cmwcmw57/pi-backup/ksrc/sim/rl/TEACHER_CMDVEL_REPORT.md

# cmdvel teacher 실험 기록 (2026-10-07)

목표는 모래·외력에서 IK의 `(vx, vy, omega)` 추종을 개선하는 밑단 잔차 정책이다.
teacher는 시뮬레이터의 참 차체속도를 포함한 43D 특권정보를 본다. 현재
`--teacher-direct` 모델은 **실기 배포용 student가 아니다**. 최종 판정은 학습에
쓰지 않은 seed에서 IK와 짝지어 병진·요속도 오차 평균/p90, 고착, 슬립·침하를
함께 확인한다. p90은 에피소드별 90분위값의 평균이다.

## 실패 원인 분리

| 실험 | 개입 | 기본 모래 40쌍, RL−IK | 판정 |
| --- | --- | --- | --- |
| `s36` | RMA 8D 잠재 teacher, 이력 5프레임, PPO 200k | 병진 평균 +0.42%vmax, p90 +0.84 | 실패. 특권 가림 시 행동 차이 0.009~0.018 |
| `s37` | 특권 43D 직접 입력, 다른 조건 동일 | 병진 평균 +0.68%vmax, p90 +0.79; 고착 1/40 | 실패. 잠재 병목만의 문제가 아님 |
| `s38` | `s37`에 참속도 P 제어기(K=0.3) 행동 모방 + 정책 방문상태 재수집 2라운드 | 병진 평균 −0.92%vmax, p90 −0.68; 요 평균 −0.69%ommax | 유효한 초기 정책. 1라운드만 쓰면 병진 p90 +4.05 |
| `s39` | `s38`부터 PPO 100k, std 0.13 | 병진 평균 −1.16%vmax, p90 −0.55 | 평균만 추가 개선 |
| `s40` | `s38`부터 PPO 100k, std 0.041 | 병진 평균 −0.80%vmax, p90 −0.45 | 좁은 탐색이 결정론 평가를 개선하지 않음 |
| `s41` | `s38`부터 PPO 100k, std 0.041, `w_tail=0.03` | 병진 평균 −0.88%vmax, p90 −1.12; 요 p90 −0.75 | 40쌍에서는 개선, 새 80쌍 검증에서 p90 이득 소멸 |
| `s42` | `s41`부터 외력 1 N으로 PPO 100k | 병진 평균 −0.69%vmax, p90 −0.38 | 외력 사후오차와 p90 모두 `s41`보다 악화 |
| `s43` | `s41`부터 에피소드 8→20초, PPO 200k | 병진 평균 −0.93%vmax, p90 −1.05 | 기본 8초는 개선. 어려운 20초의 p90 악화는 유지 |

`s41`의 **새 seed 80쌍**에서는 병진 평균 −0.69%vmax, 병진 p90
**+0.26%vmax**, 요 평균 −0.53%ommax, 요 p90 +0.24%ommax, 슬립 p90 +0.05,
침하 평균 +0.18%zmax였다. 평균만 좋아진 정책을 성공으로 고르지 않는다.

참속도 P(K=0.3) 제어기 40쌍은 병진 평균 −1.26%vmax, p90 −1.41,
요 평균 −0.72%ommax였다. 보상도 스텝당 +0.05 높으므로 개선 행동과
학습 신호는 존재한다. 그러나 슬립 p90 +0.02, 침하 +0.10%zmax의 비용이 있다.

## 외력·긴 주행

`s38`은 1 N 외력 30쌍에서 외력 종료 뒤 1초의 병진오차를 −1.62%vmax,
요오차를 −0.85%ommax 줄였지만 슬립 p90은 +0.05였다. 같은 조건에서 `s41`의
외력 사후 병진오차 이득은 −0.81%vmax(95% CI −1.67~+0.13)로 불확실하고,
`s42`는 −0.45%vmax(−1.34~+0.51)였다. 외력 샘플을 한 번 추가한 것만으로
복구 능력이 개선되지는 않았다.

어려운 모래(`difficulty=1`, `soil_amp=0.35`)의 **20초** 주행 20쌍에서 `s38`은
IK 대비 병진 p90 +1.81%vmax, `s41`은 +1.59%vmax였다. 두 정책 모두
슬립 p90 +0.04, 침하 평균 약 +0.4%zmax였다. 고착은 없었지만 긴 주행의
큰 오차는 해결하지 못했다.
`s43`도 같은 20쌍에서 병진 평균 −0.50%vmax, p90 **+1.61%vmax**,
요 평균 −0.57%ommax, 요 p90 +0.44%ommax였다. 에피소드 길이만 늘리는
방법은 큰 오차를 해결하지 못했다. 참속도 P(K=0.3)도 같은 20쌍에서
병진 평균 −1.14%vmax지만 p90 −0.09%vmax(95% CI −1.22~+1.01)로
큰 오차 개선은 확인되지 않았다. 이는 **단순 비례 제어의 한계**이지 모든
시간가변 잔차 정책의 상한이라는 뜻은 아니다.

## 바퀴별 제어 파일럿 (2026-10-07)

현재 실험된 `s36`~`s45` 정책의 행동은 모두 **차체 3D**다. 환경은
`action_mode=body+wheel`의 7D 행동을 지원한다. 뒤 4D는 IK가 낸 바퀴별
목표속도에 `(1 + 0.30*a_i)`를 곱하고 조향각은 IK가 정한다. ROS 브리지는
3D 정책만 받고 SPI 명령도 `(vx,vy,omega)`이므로 이 7D는 아직 실기 경로가
없다.

`probe_wheel_control.py`에서 동일 시드·동일 명령으로 IK, 참속도 차체
P(K=0.3), 바퀴 슬립 휴리스틱, 조합을 비교했다. 일반 모래 12쌍에서
`P+바퀴 슬립 목표`의 병진 평균은 11.069→9.427 %vmax였지만, 바퀴 네 개를
**공통 증속**한 것만으로도 9.472가 나왔다. 바퀴 간 차등만 남기면 11.147로
오히려 악화됐다. 공통 증속을 바퀴별 트랙션 제어의 성과로 세면 안 된다.
어려운 모래 20초 8쌍에서 강한 차등 규칙은 차체 P 대비 병진 평균
+0.062%vmax, 요 평균 +0.218%ommax로 악화됐다. 차체 P 정책의 상태로
미리 정의한 고슬립 비대칭 구간에서도 병진 −0.095%vmax,
요 +0.342%ommax였다. 이는 한 규칙의 결과일 뿐 7D 정책의 상한은 아니다.

`train_wheel_residual.py`는 **차체 참속도 P를 양쪽에 똑같이 고정**하고,
특권 관측 teacher가 합이 0인 바퀴 4D 차등 잔차만 학습한다. `s46` 파일럿은
단일 환경 50,176스텝, 명령 필터 0.10초, 일반 모래에서 학습했다.

| 미사용 시드 | P 대비 학습 바퀴 잔차 병진 평균 | 병진 p90 | 요 평균 | 고슬립 비대칭 구간 병진 평균 |
| --- | ---: | ---: | ---: | ---: |
| 일반 모래 20쌍, 8초 | +0.081%vmax | −0.400%vmax | +0.096%ommax | −0.183%vmax |
| 어려운 모래 10쌍, 20초 | +0.298%vmax | +0.078%vmax | +0.125%ommax | −0.059%vmax |

고슬립 구간의 이득은 작고, 어려운 모래의 **안정된 명령+고슬립** 구간에서는
병진이 오히려 +0.936%vmax였다. 일반 모래 20쌍 중 가장 나쁜 에피소드의
병진 p90 손해는 +5.579%vmax였다. 사용자 목표는 모든 구간의 우세가 아니라
보정 가능한 구간의 확실한 이득과 나머지 구간의 작은 손해다. 이 파일럿은
아직 그 조건을 만족하지 않는다. 다만 5만 스텝의 단일 학습과 작은 평가
표본이므로, 바퀴별 행동 자체가 불필요하다는 판정은 아니다. 다음에는
고슬립·비대칭 상태의 학습 노출을 늘리고 미리 정의한 구간별 이득 및 손해
상한으로 선택해야 한다.

위 평가 시드로만 **선택형 게이트**를 정했다: 명령 변경 후 0.75초 미만이면서
직전 바퀴 슬립 표준편차가 0.15를 넘을 때만 `s46`의 바퀴 잔차를 사용한다.
그 뒤에는 별도 새 시드에서 평가했다. 게이트에 쓰는 슬립은 시뮬 참값이다.

| 선택형 정책, P 대비 | 병진 평균 | 병진 p90 | 요 평균 | 전환+고슬립 병진 평균 |
| --- | ---: | ---: | ---: | ---: |
| 일반 모래 새 20쌍 | −0.038%vmax [−0.403,+0.262] | −0.880 [−2.925,+0.400] | −0.018%ommax [−0.151,+0.101] | −1.081%vmax, 에피소드 CI [−1.821,+0.272] |
| 어려운 모래 새 10쌍, 20초 | −0.024%vmax [−0.203,+0.120] | −0.473 [−1.477,+0.629] | −0.006%ommax [−0.221,+0.207] | −0.430%vmax, 에피소드 CI [−0.977,+0.175] |

대괄호는 에피소드 짝 bootstrap 95% CI다. 모든 추종 이득 CI가 0을
포함한다. 따라서 선택형 제어는 **유망한 방향**이지만 확실한 개선으로
판정할 수 없다. 일반 모래 최악 에피소드 병진 p90 손해는 +3.560%vmax,
어려운 모래는 +3.122%vmax였다. 게이트가 꺼져 있어도 앞선 행동으로
상태가 달라져 이후 손해가 0이 되지는 않는다. 어려운 모래의 평균 침하는
+0.071%zmax [ +0.005, +0.145 ] 증가했다. 추가 고착/전복은 없었다.

### 5만 스텝이 짧았는가: 같은 학습을 20만 스텝까지 연장

`s47`은 `s46`의 PPO 가중치·옵티마이저·VecNormalize를 이어 받아
총 200,192스텝까지 학습했다. 5만/10만/15만/20만 체크포인트를 **같은**
미사용 시드(기본 모래 12쌍 `30000`, 어려운 모래 20초 6쌍 `31000`)에서
차체 참속도 P와 짝비교했다. 수치는 바퀴 잔차를 더한 효과(바퀴−차체 P)다.

| 총 스텝 | 기본 병진 평균 | 기본 요 p90 | 기본 침하 | 어려운 병진 평균 | 어려운 침하 |
| ---: | ---: | ---: | ---: | ---: | ---: |
| 50k | −0.042%vmax | −0.354%ommax | +0.118%zmax | +0.506%vmax | +0.181%zmax |
| 100k | −0.037 | −0.085 | +0.405 | +0.263 | +0.892 |
| 150k | +0.275 | +1.566 | +0.308 | +0.327 | +0.743 |
| 200k | +0.017 | −0.914 | +0.273 | +0.247 | +0.428 |

같은 시드에서 차체 P 자체는 순수 IK 대비 기본 모래의 평균 병진
−1.343%vmax, 평균 요 −0.736%ommax, 어려운 모래의 평균 병진
−1.769%vmax, 평균 요 −0.939%ommax였다. 이 12/6쌍에서는
**차체 피드백의 이득이 바퀴 차등 정책의 추가 이득보다 크고 일관적**이다.
바퀴 정책의 학습을 4배 늘려도 추종 개선은 안정화되지 않았고, 모든
체크포인트에서 침하는 증가했다. 그러므로 이 특정한 `합 0인 바퀴속도 잔차 +
균일 cmdvel PPO`의 실패를 단순히 5만 스텝 부족으로 설명할 수 없다.
그러나 표본이 작고 바퀴 공통 증감속·다른 행동 표현·고슬립 집중 학습을
시험하지 않았으므로 **바퀴별 제어 일반의 가설을 기각한 것은 아니다**.

### 공통 성분·선택형 학습 재검증

`s48`은 바퀴 잔차의 합을 0으로 제한하지 않고 50,176스텝 학습했다.
새 기본 모래 12쌍에서 차체 P 대비 병진 평균 −0.009%vmax
[−0.250,+0.235], p90 −0.122 [−1.143,+1.135]로 개선을 확인하지 못했고,
침하는 +0.087%zmax [+0.028,+0.152] 증가했다. 따라서 바퀴 네 개의 공통
증감속까지 허용하는 것만으로는 부족하다.

`s49`는 명령 전환 후 0.75초 이내이고 **원시 슬립 표준편차**가 0.15를
넘을 때만 정책이 켜지도록, 어려운 모래 20초 환경에서 총 100,192스텝까지
학습했다. 확인용 별도 시드에서 차체 P 대비 결과는 다음과 같다.

| 확인 표본 | 병진 평균 | 병진 p90 | 요 평균 | 최악 에피소드 병진 p90 손해 |
| --- | ---: | ---: | ---: | ---: |
| 기본 40쌍 | +0.025%vmax [−0.070,+0.113] | +0.255 [−0.052,+0.632] | +0.017%ommax [−0.026,+0.062] | +5.370%vmax |
| 어려운 20쌍 | +0.040%vmax [−0.075,+0.167] | +0.902 [−0.147,+2.141] | +0.106%ommax [+0.003,+0.225] | +8.651%vmax |

두 표본 모두 동일 시드의 명령 일치 최대오차가 0이었다. 이 확인 표본에서
차체 P 자체는 IK 대비 기본 모래 병진 평균 −1.412%vmax
[−1.722,−1.096], 요 평균 −0.715%ommax [−0.829,−0.601]이었다.
어려운 모래에서는 병진 평균 −0.990%vmax [−1.352,−0.594], 요 평균
−0.680%ommax [−0.810,−0.533]이었다. 즉 현재 실험의 차체 참속도 피드백은
재현되지만 바퀴별 정책의 *추가* 개선은 재현되지 않는다. 이는 **oracle
차체 P**의 결과이지 배포 가능한 학습 정책의 성능이 아니다.

이 선택형 학습의 게이트는 이후 계측에서 잘못된 선택 기준임이 드러났다.
`audit_wheel_opportunities.py`로 어려운 모래 20쌍, 약 19,423제어주기를
계측하면 명령 전환 중 원시 슬립 표준편차 >0.15는 **35.2%**지만, 실제
명령 구동 방향에 슬립 부호를 맞추고 접지 중인 바퀴만 본 표준편차 >0.15는
**2.4%**다. 전체에서는 각각 19.6%, 2.6%였다. 회전·방향 전환 시 부호가
다른 바퀴를 `s49`가 잘못 선택했다. 원시 게이트로 학습한 실패를
바퀴별 트랙션 제어 가설의 반증으로 해석할 수 없다.

`soil_amp=1.0`인 진단용 강한 패치에서는 구동 방향 기준 슬립차 >0.05가
전체 20.2%, >0.15가 4.6%였다. 후자 상태의 병진오차는 17.00%vmax로,
나머지 접지 상태의 7.51%vmax보다 크다. 다만 이 연관성만으로 바퀴별
제어가 오차를 줄일 수 있다고 증명되지는 않는다. 구동 방향 기준 게이트로
학습·평가하는 후속 실험이 필요하다.

### 구동 방향 기준 게이트와 어려운 패치 학습 (`s50`)

원시 슬립 부호 착오를 고친 `gate_metric=traction`을 넣었다. 명령 구동
방향에 슬립 부호를 맞추고, 충분한 명령과 접지력이 있는 바퀴가 셋 이상일 때
표준편차가 0.05를 넘으면 차등 바퀴 정책을 켠다. 명령 전환뿐 아니라
2초 명령 구간 전체를 사용한다. 강한 패치(`soil_amp=1.0`)에서
100,352스텝을 처음부터 학습하고 50k/100k 체크포인트를 같은 독립 시드
20쌍씩 평가했다. 모두 **차체 참속도 P를 고정한 상태에서 바퀴 잔차를 추가**한
결과다.

| 학습 스텝 | 검증 분포 | P 대비 병진 평균 | 병진 p90 | 요 평균 | 침하 평균 |
| ---: | --- | ---: | ---: | ---: | ---: |
| 50k | 강한 패치 20쌍 | +0.326%vmax [−0.262,+1.254] | +0.579 [−1.474,+3.513] | −0.079%ommax [−0.393,+0.130] | +0.252%zmax |
| 100k | 강한 패치 20쌍 | +0.210%vmax [+0.029,+0.454] | +0.005 [−0.717,+0.663] | +0.087%ommax [+0.020,+0.154] | +0.207%zmax [+0.090,+0.352] |
| 50k | 목표 모래 20쌍 | +0.193%vmax [−0.053,+0.539] | +0.352 [−0.267,+1.167] | +0.055%ommax [−0.031,+0.165] | −0.023%zmax |
| 100k | 목표 모래 20쌍 | +0.117%vmax [−0.145,+0.410] | +0.670 [−0.243,+1.725] | +0.014%ommax [−0.095,+0.127] | +0.033%zmax |

50k를 강한 패치의 다른 6쌍에서만 보면 병진 p90 −0.876%vmax였으나
CI [−2.071,+0.101]로 불확실했고, 20쌍으로 늘리자 이득이 사라졌다.
50k→100k에서 병진 **평균 손해는 줄었으므로** 학습량 부족을 완전히
배제할 수는 없다. 다만 의도한 강한 비대칭 슬립(구동 방향 기준 표준편차
>0.15)에서 병진오차의 스텝 평균은 50k +0.785, 100k +0.906%vmax로
모두 나빠졌다. 이 구간은 원래 차체 P 궤적의 상태로 미리 선택했다.
에피소드 길이가 다른 구간의 스텝 가중 평균과 에피소드별 bootstrap CI는
가중법이 달라, 여기서는 구간 CI로 유의성 판정을 하지 않는다.

같은 강한 패치 20쌍에서 차체 P는 IK보다 병진 평균 −1.689%vmax
[−2.392,−1.136], 요 평균 −0.561%ommax [−0.822,−0.321]이었다.
목표 모래 20쌍에서는 병진 평균 −1.478%vmax [−1.762,−1.164], 요 평균
−0.601%ommax [−0.811,−0.390]이었다. 따라서 **현재는 차체 참속도
피드백의 평균 오차 이득만 재현됐다**. 이것은 참값 oracle이며 학습된
차체 teacher 또는 실기 배포 정책의 이득이라는 뜻은 아니다.

`s50`은 실험적 강한 패치, 최대 ±30% 바퀴속도 잔차, 차등 성분,
PPO 100k의 결과다. 바퀴별 액션 일반의 가설을 기각하지 않는다. 다만
현재 구성에서 학습 시간을 무작정 늘리기보다, 바퀴 행동으로 실제
오차를 줄일 수 있는 상태를 별도로 입증하고 그 상태를 반복 학습시키는
것이 우선이다.

추가로 구동 방향 기준 슬립 차이를 줄이는 단순 차등 규칙을 강한 패치
8쌍에서 시험했다(`probe_wheel_control.py`, `wheel_mode=differential`,
`wheel_gain=2`). 차체 P 대비 병진 평균 +1.539%vmax, p90 +2.851,
고비대칭 슬립 구간 병진 스텝 평균 +0.399%vmax로 악화됐다. 이 규칙의
실패는 최적 바퀴 정책이 없다는 증거는 아니다. 특히 현재 terramech의
접지 마찰계수는 슬립 절댓값에 대해 포화하며 **단조 증가**하고, 침하
저항은 별도로 누적된다. 과도한 회전을 줄이면 즉시 접지력이 오르는
타이어 모델을 가정한 규칙을 그대로 적용할 수 없다.

강한 패치 10쌍의 상태 계측에서는 **의미 있는 구동 명령과 접지를 동시에
가진 바퀴가 3개 미만**인 주기가 전체 31.5%였고 그때 병진오차는
29.38%vmax였다. 셋 이상인 68.5% 주기의 병진오차는 8.15%vmax였다.
이는 접지 바퀴 수 자체만을 센 값이 아니라, 구동 명령이 거의 0인 바퀴도
제외한 값이다. 큰 오차의 상당수가 명령 전환·조향 대기 등 바퀴속도
차등 보정이 힘을 내기 어려운 상태에 몰릴 가능성을 보여준다. 접촉 원인과
조향 대기를 따로 계측하기 전에는 이를 모두 공중 바퀴 탓으로 돌릴 수 없다.

명령 변경 뒤 구간별 진단(20쌍): `s41`은 0.75~2초에는 병진 평균 −1.11,
p90 −0.87%vmax였지만 첫 0~0.25초의 병진 p90은 +1.59%vmax였다.
0.25~0.75초의 IK 병진 p90 자체가 41.92%vmax다. 조향 최고속도
5.2 rad/s에서는 180° 회전에 약 0.60초가 필요하므로 전환 구간 오차는
제어 한계와 분리해 해석해야 한다. 단순히 명령 변경 후 0.25/0.5초 동안
잔차를 차단하면 기본 40쌍의 병진 p90은 `s41`의 22.10에서 각각 22.73,
23.11%vmax로 악화되어 채택하지 않았다.

ROS 브리지는 기본 `cmd_filter_tau=0.10s`이고, 이전 cmdvel 학습은
`alpha=1/(0.3*50)=0.06667`이었다. 브리지의 계수식은
`alpha=dt/(tau+dt)`이다. 환경에 `cmd_filter_tau`를 노출하고 동일한
식으로 고쳤다. 기본 0.28s는 종전 alpha를 정확히 보존하며 0.10s는
ROS와 같은 alpha=0.16667이다.

ROS 기본 0.10s 필터의 새 seed 30쌍(`seed0=16000`)에서 `s43`은 IK 대비
병진 평균 −0.49%vmax, p90 **+1.04%vmax**, 요 p90 +1.00%ommax였다.
반면 참속도 P(K=0.3)는 병진 평균 −1.35%vmax, p90 **−1.82%vmax**
(95% CI −3.44~−0.23)였다. 따라서 빠른 명령에서도 보정 여지는 있는데
기존 teacher가 그 분포를 재현하지 못한다.

0.10s 명령으로 두 라운드 행동 모방한 `s44`도 같은 30쌍에서 병진 p90
+1.31%vmax였다. 별도 40쌍(`seed0=18000`)에서는 병진 평균 −0.75%vmax,
p90 −0.19%vmax(95% CI −1.66~+1.71)로 큰 오차 이득은 불확실하다.
행동과 속도오차의 상관은 0.94~0.96이고 축별 유효 P 이득도 0.28~0.34로
목표 0.3에 가깝지만, 작은 모방 오차가 폐루프 p90에 영향을 준다.

## 같은 상태 바퀴별 권한 실험 (2026-10-07)

`probe_wheel_same_state.py`로 **같은 MuJoCo 물리 상태·흙 침하 메모리·IK
fold 상태·명령/지연·난수 상태**를 복제했다. 참속도 차체 P(K=0.3)는 모든
분기에서 동일하게 유지하고, 그 위의 바퀴별 잔차만 0.30초 동안 바꿨다.
선택 기준은 P 기준 궤적에서 구동·접지 바퀴 3개 이상, 조향 정렬 대기 아님,
명령 시작 후 0.75~1.50초, 구동 방향 기준 슬립 표준편차가 목표 모래 0.05
또는 강한 패치 0.12 이상이다. 에피소드당 최대 2상태만 택했다. 차등 후보는
한 바퀴/바퀴쌍의 ±입력과 슬립·흙 마찰계수 기준 입력으로 구성했고, 모든
바퀴의 평균 보정은 0이다. 별도로 네 바퀴 공통 증감도 시험했다. 바퀴당
허용 범위는 기존의 IK 속도 ±30%다.

| 패치 | 상태 수 (시드 수) | P 병진/요 오차 | 사후 최선 차등 Δ병진/Δ요 | 단순 슬립 감소 Δ병진/Δ요 | `s50` Δ병진/Δ요 |
| --- | ---: | ---: | ---: | ---: | ---: |
| 목표 `soil_amp=0.25` | 33 (18) | 7.02 / 4.37 | −1.22 / −1.20 | +1.62 / +1.48 | +0.09 / +0.09 |
| 강한 `soil_amp=1.0` | 23 (15) | 12.18 / 8.06 | −1.34 / −0.40 | +0.66 / +1.89 | −0.01 / −0.11 |

수치는 각 상태에서 0.30초 평균 오차의 차이이며 각각 `%v_max`,
`%omega_max` 단위다. 음수가 개선이다. `s50`은 매 20ms마다 실제 학습
정책을 다시 호출하고 학습 당시 게이트(슬립 편차 >0.05, 명령 시작 뒤
2초 이내)를 적용했다. 목표 모래의 `s50` 병진 차이의 시드 단위 bootstrap
95% CI는 [−0.05,+0.22]%v_max, 강한 패치는 [−0.45,+0.21]%v_max다.
차등 후보 중 병진과 요오차를 **함께** 줄이는 입력이 목표 모래 26/33,
강한 패치 19/23 상태에 있었다. 그러나 `s50`은 각각 10/33, 8/23뿐이다.

따라서 **현재 물리 모델과 액션 범위 안에 국소 바퀴별 보정 권한은 있지만,
`s50`은 이를 배우지 못했다.** 사후 최선은 미래 0.30초를 보고 유한한
후보들 중 고른 값이라 정책의 성능이 아니고, 한 상태의 단기 개선이 긴
에피소드의 p90·침하 개선을 보장하지도 않는다. 또한 참속도 P 위에 얹은
결과이므로 실기 배포 가능한 student의 성능이라는 주장도 아니다.
반대로 이 결과만으로 바퀴별 제어 가설을 기각할 수는 없다. 슬립 큰 바퀴를
그냥 늦추는 규칙은 두 분포 모두에서 실패했고, 최선 후보의 방향도 상태마다
달랐다. 강한 패치에서 공통 바퀴 증감의 사후 최선 병진 개선은 −2.49%v_max로
차등보다 컸지만, 이것은 바퀴별 재분배의 성과가 아니다.

논문 ERNEST는 속도 명령을 저수준 제어에 넣고 상대적인 바퀴 하중을
관측한다. 이 환경은 IK 바퀴속도를 **개루프 duty**로 바꾼다. 그래서
알고리즘·보상 숫자를 옮기기 전에, 같은 상태에서 후보가 달라지는 원인을
관측으로 예측 가능한지 검사하고, 바퀴 속도 폐루프/행동 유지시간을 별도
가설로 시험해야 한다. `s50`을 같은 분포에서 단순 연장 학습하는 것만으로
개선된다고 볼 근거는 없다.

재현 예시 (현재 `sim/rl`에서 실행):

```bash
OPENBLAS_NUM_THREADS=1 python3 probe_wheel_same_state.py --episodes 20 --seed0 42000 --episode-s 10 --soil-amp 0.25 --spread 0.05 --policy-model ../../runs/s50_wheel_traction_gate_100k/model.zip --policy-vecnorm ../../runs/s50_wheel_traction_gate_100k/vecnorm.pkl --out /tmp/ksrc_wheel_probe_target_s50.json
OPENBLAS_NUM_THREADS=1 python3 probe_wheel_same_state.py --episodes 20 --seed0 41000 --episode-s 10 --soil-amp 1.0 --spread 0.12 --policy-model ../../runs/s50_wheel_traction_gate_100k/model.zip --policy-vecnorm ../../runs/s50_wheel_traction_gate_100k/vecnorm.pkl --out /tmp/ksrc_wheel_probe_strong_s50.json
```

## 정상 주행의 지속 오차를 겨냥한 teacher 개선 (`s51`, 2026-10-07)

ROS와 같은 `cmd_filter_tau=0.10s`에서 `s45`를 새 기본 모래 40쌍으로
평가했다. IK 대비 병진 평균 −0.73%vmax [−1.16,−0.25], 요 평균
−0.51%ommax [−0.71,−0.26]였지만, 병진 p90 이득은 불확실했다.
명령 시작 0.75~2초의 병진 p90은 IK 12.14, `s45` 13.52,
참속도 P(K=0.3) 10.08%vmax였다(20쌍). `s45`가 모방해야 할
지속 오차 보정이 남아 있었다.

그래서 `behavior_clone_cmdvel.py`에 **명령 시작 후 0.75초가 지난
병진오차 샘플의 모방 손실 가중치**를 추가했다. `s45`에서 시작해
80개 에피소드의 참속도 P 시범·정책 방문상태를 두 라운드로 모으고,
`steady-tail-weight=3`으로 학습한 결과가 `s51`이다. 이는 PPO 보상
최적화가 아니라 **특권 teacher의 지도학습/DAgger 추가 학습**이다.

| 독립 평가 | 지표 | IK | `s45` | `s51` | `s51−s45` 짝 bootstrap 95% CI |
| --- | --- | ---: | ---: | ---: | ---: |
| 기본 모래 40쌍, 8초 | 병진 평균, %vmax | 11.915 | 10.634 | **10.421** | **−0.213 [−0.339,−0.087]** |
| | 병진 p90, %vmax | 26.610 | 26.153 | **25.277** | **−0.876 [−1.603,−0.241]** |
| | 요 평균, %ommax | 4.940 | 4.416 | 4.406 | −0.010 [0 포함] |
| | 요 p90, %ommax | 9.851 | 10.498 | **9.685** | **−0.812 [−1.471,−0.277]** |
| 어려운 모래 20쌍, 20초 | 병진 평균, %vmax | 13.862 | 12.893 | **12.501** | **−0.392 [−0.864,−0.085]** |
| | 병진 p90, %vmax | 32.223 | 32.007 | 31.355 | −0.651 [0 포함] |
| | 평균 침하, %zmax | 3.900 | 4.151 | 4.051 | −0.100 [−0.215,−0.020] |

기본 모래는 미사용 seed `36000`부터 40쌍, `difficulty=0.8`,
`soil_amp` 기본값이다. 어려운 모래는 seed `38000`부터 20쌍,
`difficulty=1`, `soil_amp=0.35`다. 모든 팔의 명령 차이 최대값은 0,
고착·전복·경계 이탈은 0이었다. 기본 모래의 `s51−IK` 병진 평균은
−1.493%vmax [−1.821,−1.152]이지만 병진 p90은 −1.333
[−2.471,+0.100]으로 **IK 대비 p90 개선은 아직 확정되지 않았다**.
슬립 p90은 IK 0.500, `s51` 0.522이고 침하는 IK 2.544,
`s51` 2.690%zmax로 증가했다. 어려운 모래에서도 `s51` 침하가 IK보다
+0.151%zmax [+0.011,+0.290] 높았다.

1 N 외력 20쌍(seed `39000`)에서는 `s51−IK` 외력 후 병진 평균
−1.032%vmax [−1.986,−0.118]였다. 그러나 `s51−s45`는 +0.041
[−0.351,+0.405]로 **이전 teacher 대비 외력 복구 향상은 입증되지 않았다**.
`s51`은 일반 명령 추종을 개선한 teacher이며 실기용 student가 아니다.
참속도 특권 관측과 정상화 파일이 필요하고, ROS의 배포 모델로 바로
바꾸면 안 된다.

별도 가설로 참속도 P 위에 10Hz TD3 잔차(`s52`, 10k스텝)를 학습했다.
미사용 seed `47000`부터 20쌍에서 P 대비 병진 평균 +1.493%vmax
[+0.702,+2.350], 요 p90 +2.435%ommax [+0.186,+4.759],
침하 +0.430%zmax [+0.279,+0.605]로 악화됐다. 5k 체크포인트도
병진 평균·요 평균·침하가 악화됐다. 따라서 TD3 잔차는 **채택하지 않는다**.

### 더 강한 모래 패치 외삽 평가

`difficulty=1.0`은 지형 생성기의 상한이지만 기본 에피소드 난도는
`U(0.6,1.0)`으로 뽑힌다. 따라서 아래 두 평가는 최상위 난도만 고정한
것이 아니라 상위 난도가 섞인 분포다. `soil_amp=1.0`은 기본
0.25보다 바퀴별 모래 마찰 차이를 네 배 키운 스트레스 시험이다.
`soil_field`에서 배율의 표준편차가 난이도에 비례해 증가하고, 최종 바퀴
마찰계수는 `[0.15,1.20]`으로 잘린다. 이 정도 패치가 실제 경기장 모래의
측정 분포라는 근거는 없으므로 **분포 밖 내구성 시험**으로 해석한다.

미사용 seed `50000`부터 20쌍, 20초, 0.10초 명령 필터에서 결과는 다음과 같다.

| 지표 | IK | `s45` | `s51` | 참속도 P |
| --- | ---: | ---: | ---: | ---: |
| 병진 평균, %vmax | 19.501 | 18.280 | 18.493 | 19.938 |
| 병진 p90, %vmax | 43.324 | 41.663 | 42.482 | 46.445 |
| 요 평균, %ommax | 8.551 | 7.798 | 7.879 | 8.307 |
| 평균 침하, %zmax | 4.706 | 5.092 | 5.228 | 5.342 |
| 고착 에피소드 | 2/20 | 3/20 | 3/20 | 3/20 |

`s51−IK` 병진 평균은 −1.008%vmax [−2.142,+0.056]으로 CI가 0을
포함한다. 침하는 **+0.522%zmax [+0.138,+0.911]**로 확실히 높다.
`s51−s45` 병진 평균은 +0.213%vmax [−0.380,+1.030]이며 s51의
일반 모래 개선은 여기서 유지되지 않는다. 참속도 P도 IK보다 병진 평균·p90이
나빠졌으므로 이 조건에서 P 행동을 더 모방하는 방향은 부적절하다.
모든 팔의 명령 불일치는 0이었다.

중간 패치 `soil_amp=0.5`에서도 같은 `difficulty=1.0`, 20초,
새 seed `51000`부터 20쌍을 평가했다. IK/`s45`/`s51`/참속도 P의 병진
평균은 13.697/12.524/12.485/12.445%vmax였다. `s51−IK`는
−1.212 [−1.612,−0.804]로 평균 추종 개선이 남았으나, 병진 p90
−0.687 [−2.184,+0.721]은 불확실하다. `s51−s45` 병진 평균
−0.039 [−0.244,+0.208]로 추가 이득은 사라졌고, 요 평균은
+0.147%ommax [+0.005,+0.336] 악화됐다. IK 대비 슬립 p90은
+0.056 [+0.024,+0.096], 침하는 +0.431%zmax [+0.154,+0.775]였다.
고착·전복·경계 이탈은 네 팔 모두 0이었다.

같은 `soil_amp=0.5` 20쌍에서 `s51`의 출력만 50%로 줄이는 절제 실험을
했다. 병진 평균은 12.485→12.964%vmax로 **+0.479
[+0.195,+0.703] 악화**했지만, 슬립 p90은 0.590→0.570
[차이 −0.040,−0.001], 침하는 4.761→4.584%zmax
[차이 −0.300,−0.080]로 감소했다. 즉 잔차를 줄이면 피해가 완화되지만
보정 이득도 일부 잃는다. 단순히 행동 전체에 0.5를 곱한 모델을 최종
정책으로 채택할 근거는 없다.

`soil_amp=1.0`에서도 앞선 평가와 겹치는 12쌍의 탐색 결과, 50% 출력은
원래 `s51`보다 병진 평균 **+1.376%vmax [+0.409,+2.571]**, 요 평균
+0.885%ommax [+0.275,+1.713]로 악화됐다. 침하는 −0.395%zmax
[−0.772,−0.141] 감소했다. 같은 시드를 재사용한 **절제 진단**이며,
절반 출력이 추종을 개선한다는 증거는 아니다. 이 규모 축소는 채택하지 않는다.

PPO 외의 연속행동 알고리즘으로 `s53` SAC를 시험했다. 참속도 P를
고정한 위에 10Hz 차체 잔차를 얹고, `difficulty=1.0`, `soil_amp=1.0`,
12초 에피소드에서 10k macro-step을 학습했다. `s51`의 관측 정규화
통계를 고정해 썼고, 잔차 크기는 기존 행동 한계의 25%였다. 새 seed
`55000`부터 20쌍에서 P 대비 병진 평균 **+1.058%vmax
[+0.171,+2.001]**로 악화했고, 고착은 P 0/20, SAC 1/20이었다.
학습 보상이 증가해도 독립 평가가 나빠진 경우다. 같은 20쌍에서 5k
체크포인트의 P 대비 병진 평균은 +1.793%vmax
[−0.308,+5.278], 요 평균은 +0.427%ommax [+0.044,+0.837]였다.
따라서 **SAC도 채택하지 않는다**. 이는 SAC 알고리즘 일반의
실패가 아니라 이 보상·관측·10k스텝·참속도 P 기준선의 결과다.

### 난도를 매번 최댓값으로 고정한 지형

기존 `difficulty=1.0`의 에피소드별 난도는 `U(0.6,1.0)`이었다. 환경에
`difficulty_min_frac`를 추가하되 기본값은 0.6으로 유지했다. 평가에
`--difficulty-min-frac 1`을 주면 매 에피소드의 지형·흙 난도가 정확히
`d_ep=1.0`이 된다. `soil_amp=0.5`를 유지하고 독립 seed `60000`부터
20쌍, 20초를 평가했다.

| 지표 | IK | `s45` | `s51` | 참속도 P | `s51−IK` 짝 bootstrap 95% CI |
| --- | ---: | ---: | ---: | ---: | ---: |
| 병진 평균, %vmax | 14.769 | 13.943 | 14.350 | 13.730 | −0.419 [−1.237,+0.874] |
| 병진 p90, %vmax | 31.593 | 31.676 | 33.085 | 31.712 | +1.492 [−1.688,+5.794] |
| 요 평균, %ommax | 7.189 | 6.717 | 6.906 | 6.666 | −0.283 [−0.620,+0.192] |
| 슬립 p90 | 0.542 | 0.589 | 0.594 | 0.596 | +0.052 [+0.017,+0.087] |
| 평균 침하, %zmax | 6.144 | 6.654 | 7.006 | 6.880 | **+0.862 [+0.333,+1.612]** |

고착·전복·경계 이탈은 모두 0/20, 명령 불일치 최대값은 0이다.
`s51−s45` 병진 평균은 +0.407%vmax [−0.266,+1.437]로 추가 이득이
확인되지 않았고, p90은 +1.409 [−1.106,+4.898]이다. 최악 난도에서
평균·꼬리 오차의 이득은 불확실하지만 침하와 슬립 비용은 확인됐다.
따라서 **현재 s51의 유효 범위는 이전의 일반 모래 검증 조건까지**이며,
최상위 난도에 그대로 적용할 근거는 없다. P oracle도 침하를 키우므로
P 모방만 더 하는 것이 해결책은 아니다. 이 결과는 20쌍의 시뮬 모델
스트레스 시험이지 실제 경기장 모래의 성능 보증이 아니다.

### 어려운 지형에서 PPO 이어학습 (`s54`, 2026-10-07)

`s51`의 223D 특권 관측·3D 차체 잔차 PPO를 이어서 학습했다. 난도는 매
에피소드 `U(0.9,1.0)`, `soil_amp=0.5`, 20초, ROS와 같은 0.10초 명령
필터다. `w_tail=0.03`, 8환경, 추가 100k스텝, 이어학습률 `3e-5`,
목표 KL `0.01`, 탐색 표준편차 `exp(-3.2)`를 사용했다. 모방학습으로 바뀐
actor 때문에 PPO optimizer는 초기화했으며 정규화 통계는 이어받아
학습 분포에서 업데이트했다. 이전 환경 스냅샷과 현재의 난도 하한 옵션이
달라 `--allow-source-change`를 명시했다. 유효 런은
`runs/s54_cmdvel_hardtail_ppo_100k_retry/`에 있고, 같은 이름에서
`_retry`가 없는 디렉터리는 샌드박스의 병렬 프로세스 생성 차단으로
학습 전에 종료된 시도다.

체크포인트 선택용 미사용 seed `65000`부터 12쌍, 난도 1.0 고정·패치
0.5·20초에서 50k 모델은 `s51` 대비 병진 평균 +0.104%vmax
[−0.156,+0.360], 요 평균 +0.188%ommax [+0.011,+0.421],
침하 +0.157%zmax [+0.021,+0.322]였다. 100k 모델은 병진 평균
−0.370 [−1.020,+0.136]으로 개선 여부가 불확실하고, IK 대비 요 p90은
+1.871%ommax [+0.037,+3.866]로 악화했다. 이 12쌍은 모델 선택에
사용했으므로 채택 근거로 삼지 않는다.

별도의 일반 모래(`difficulty=0.8`, `soil_amp=0.25`, 8초) seed `68000`
30쌍에서 `s54−s51` 병진 평균은 **−0.254%vmax
[−0.432,−0.064]**, 병진 p90은 +0.077 [−0.906,+1.432],
평균 침하는 −0.020%zmax [−0.048,+0.006]이었다. 일반 모래에서는
평균 추종이 추가 개선됐으나 p90·침하 개선은 확인되지 않았다.
학습 목표인 최상위 난도의 별도 30쌍 결과는 아래와 같다.

최상위 난도 고정(`difficulty=1`, `difficulty_min_frac=1`, `soil_amp=0.5`,
20초)의 **새 seed `66000`부터 30쌍** 결과는 다음과 같다. 같은 시드의
명령 차이 최대값은 0이다.

| 지표 | IK | `s51` | `s54` 100k | `s54−s51` 짝 bootstrap 95% CI | `s54−IK` 짝 bootstrap 95% CI |
| --- | ---: | ---: | ---: | ---: | ---: |
| 병진 평균, %vmax | 14.341 | 12.817 | 12.809 | −0.008 [−0.253,+0.335] | −1.532 [−2.156,−0.985] |
| 병진 p90, %vmax | 33.977 | 31.363 | 31.618 | +0.255 [−0.705,+1.080] | −2.358 [−4.258,−0.694] |
| 요 평균, %ommax | 6.628 | 5.989 | 6.302 | **+0.313 [+0.144,+0.543]** | −0.326 [−0.629,−0.021] |
| 슬립 p90 | 0.616 | 0.641 | 0.672 | **+0.032 [+0.012,+0.055]** | +0.056 [+0.025,+0.093] |
| 평균 침하, %zmax | 4.445 | 4.576 | 4.864 | **+0.288 [+0.039,+0.632]** | +0.419 [+0.144,+0.764] |
| 고착 에피소드 | 0/30 | 0/30 | 1/30 | 1건 추가 | 1건 추가 |

`s54`는 IK보다 병진 추종을 개선하지만, **기존 s51 대비 추가 병진 이득은
확인되지 않았다**. 요 평균·슬립·침하는 악화됐고 고착도 하나 발생했다.
일반 모래의 평균 병진 −0.254%vmax 추가 이득은 이 비용을 상쇄한다고
보기 어렵다. 따라서 `s54`는 실험 모델로 보존하되 기본 teacher로
**채택하지 않는다**. 이 실험에서 학습을 더 늘리는 것만으로 해결된다는
증거도 없다. P oracle/현 보상이 침하·고착 비용을 충분히 나타내는지와
보정이 유리한 상태를 따로 구분할 수 있는지를 다음 가설로 확인해야 한다.

재현 예시 (`sim/rl`에서 실행):

```bash
OPENBLAS_NUM_THREADS=1 python3 compare_cmdvel_models.py --old-model runs/s45_cmdvel_teacher_bc_ros_tau_refine/model.zip --old-vecnorm runs/s45_cmdvel_teacher_bc_ros_tau_refine/vecnorm.pkl --new-model runs/s51_cmdvel_steady_tail_bc/model.zip --new-vecnorm runs/s51_cmdvel_steady_tail_bc/vecnorm.pkl --episodes 40 --seed0 36000 --cmd-filter-tau 0.10
OPENBLAS_NUM_THREADS=1 python3 compare_cmdvel_models.py --old-model runs/s45_cmdvel_teacher_bc_ros_tau_refine/model.zip --old-vecnorm runs/s45_cmdvel_teacher_bc_ros_tau_refine/vecnorm.pkl --new-model runs/s51_cmdvel_steady_tail_bc/model.zip --new-vecnorm runs/s51_cmdvel_steady_tail_bc/vecnorm.pkl --episodes 20 --seed0 38000 --episode-s 20 --difficulty 1 --soil-amp 0.35 --cmd-filter-tau 0.10
OPENBLAS_NUM_THREADS=1 python3 compare_cmdvel_models.py --old-model runs/s45_cmdvel_teacher_bc_ros_tau_refine/model.zip --old-vecnorm runs/s45_cmdvel_teacher_bc_ros_tau_refine/vecnorm.pkl --new-model runs/s51_cmdvel_steady_tail_bc/model.zip --new-vecnorm runs/s51_cmdvel_steady_tail_bc/vecnorm.pkl --episodes 20 --seed0 60000 --episode-s 20 --difficulty 1 --difficulty-min-frac 1 --soil-amp 0.5 --cmd-filter-tau 0.10
OPENBLAS_NUM_THREADS=1 python3 compare_cmdvel_models.py --old-model runs/s51_cmdvel_steady_tail_bc/model.zip --old-vecnorm runs/s51_cmdvel_steady_tail_bc/vecnorm.pkl --new-model runs/s54_cmdvel_hardtail_ppo_100k_retry/final.zip --new-vecnorm runs/s54_cmdvel_hardtail_ppo_100k_retry/vecnorm.pkl --episodes 30 --seed0 66000 --episode-s 20 --difficulty 1 --difficulty-min-frac 1 --soil-amp 0.5 --cmd-filter-tau 0.10
```

## 재현과 다음 판정

각 `runs/sNN.../manifest.json`에 인자·소스 해시, `src/`에 실행 당시 코드가
남아 있다. `compare_policy.py`는 동일 seed로 IK와 정책을 짝비교하지만
주행 궤적이 갈라진 뒤 센서 잡음 난수 소비까지 완전히 공통은 아니다.
`probe_cmdvel_phase.py`는 명령 변경 후 구간별 오차를 출력한다.

현재 선택할 수 있는 **검증 완료 배포 모델은 없다**. `s51`은 `s45`보다
독립 시드의 일반 모래 명령 추종이 개선된 teacher다. 최상위 난도에서는
시드에 따라 IK 대비 추종 이득이 달라지고 침하 비용이 남아 있다. 어려운
지형 PPO 이어학습 `s54`는 `s51`보다 요 평균·슬립·침하를 악화시켜
채택하지 않았다. 실기 센서만으로 가능한
속도 추정/관측과 student 증류, 그 student의 독립 재평가가 다음 판정이다.

## 보상 항 진단과 논문 코드 검토 (2026-10-07)

최상위 난도 고정·새 seed `66000`부터 30쌍을 `w_tail=0.03`으로
재계산했다. 아래는 에피소드별 스텝 평균을 다시 30개 에피소드에 대해
평균한 값이다. 짝 bootstrap 95% CI를 썼다.

| 스텝당 보상 항 | `s51` | `s54` | `s54−s51` 95% CI |
| --- | ---: | ---: | ---: |
| 병진 추종 `track_v` | +0.404832 | +0.402794 | −0.002039 [−0.010272,+0.003814] |
| 요 추종 `track_om` | +0.318348 | +0.313345 | **−0.005003 [−0.007875,−0.002663]** |
| 큰 오차 비용 `tail` | −0.066912 | −0.066518 | +0.000394 [−0.005824,+0.007697] |
| 잔차 사용 `resid` | −0.000191 | −0.000212 | −0.000021 [−0.000029,−0.000013] |
| 잔차 2차 차분 `smooth` | −0.000023 | −0.000025 | −0.000002 [−0.000003,−0.000001] |
| 합계 | +0.656055 | +0.649201 | −0.006854 [−0.021956,+0.003130] |

따라서 단순히 `smooth` 비용이 커서 정책이 조용히 있는 경우로 볼 수 없다.
`s54`의 추종 보상 자체가 늘지 않았고, 요 추종 보상은 줄었다. 현재
cmdvel 보상에는 스텝별 슬립·침하·명령 포화 비용이 없다. 고착 종료
벌점은 있으나 고착 이전의 침하 누적은 직접 반영하지 않는다. 저항이
큰 모래에서는 명령을 더 세게 줄수록 슬립·침하가 커져도 추종 오차가
별로 줄지 않는 상태가 있는지 상태별로 확인해야 한다. 보상 탓으로
단정하기 전에 IK와 teacher의 동일 초기 상태·명령에서 **안전한 개선
행동이 실제로 존재하는지**와 그 행동이 보상에서 더 높은지 분리해야 한다.

사용자가 제공한 두 PDF와 추가로 논의한 ERNEST 논문의 공개 코드를
2026-10-07에 확인했다.

| 논문 | 공개 코드 | 현재 cmdvel teacher에 적용 가능성 |
| --- | --- | --- |
| [Joglekar et al. 2022, skid-steer adaptive Pure Pursuit](https://www.sciencedirect.com/science/article/pii/S2405896322028592) | 저자 [Deep_Reinforcement_Adaptive_Pure_Pursuit](https://github.com/ajinkya-joglekar/Deep_Reinforcement_Adaptive_Pure_Pursuit), ROS1 catkin·MATLAB/Gazebo 코드. PDF 참고문헌의 `mecc_22_rl_pid` 경로는 현재 열리지 않고 저자 계정의 이 저장소가 공개돼 있다. | RL 행동은 전진속도·lookahead이며 하위 구동기 슬립 보정 코드가 아니다. Nav2 경로 추종기 조정 실험에만 간접 참고. `RL_pipeline.m`에는 관측의 속도 자리에 명령 속도를 넣고, 보상의 목표 속도 1.5가 actor 출력 범위 0.2–0.5 밖에 있는 불일치도 있어 그대로 이식하지 않는다. |
| [Lee & Joe 2026, 4WIS path tracking](https://doi.org/10.3390/s26061761) | PDF에 공개 코드 링크가 없고 데이터는 저자 요청 시 제공이라고 기재. 제목·저자·DOI로 검색해 공식 GitHub 저장소를 확인하지 못했다. | 25D 경로 관측, PPO 59M 스텝, 가상 구동각속도·조향각 행동을 하위 wheel-wise 기구학에 배분하는 **상위 경로 추종기**다. 현재 차체 `(vx,vy,omega)` 밑단 잔차 학습에는 보상을 직접 복사하면 목표가 달라진다. 실측 조향 지연·GPS 잡음을 랜덤화 범위로 잡는 방법은 실기 이전 단계에 참고 가능. |
| [Bouton et al. 2026, ERNEST](https://arxiv.org/html/2606.06790v2) | 저자가 링크한 [MachineLearning/TD3.py](https://github.com/arthur-bouton/MachineLearning/blob/master/TD3.py)는 TensorFlow 2.3.1 기반 범용 TD3와 pendulum/cartpole 예제다. DARTS 로버 환경·학습 설정·체크포인트는 해당 저장소에 없다. | TD3의 경험 재사용, 지형별 학습 후 replay 통합, 이전 행동 관측, 토양 모델의 drawbar-pull 실측 검증은 적용 아이디어다. 다만 행동은 전진속도와 능동 서스펜션 yaw/roll 속도이고 보상은 경로 진행·횡오차·서스펜션 토크라 현재 스워브 차체 속도 잔차에 직접 이식할 수 없다. |

특히 2026 4WIS와 ERNEST는 경로를 **앞으로** 추종하는 실험이다. 현재
cmdvel 과제는 임의의 차체 `(vx, vy, omega)`를 추종하므로, 경로 진행·전방
헤딩 게이트를 그대로 넣으면 횡이동·후진 명령을 잘못 벌할 수 있다. 이
보상들은 Nav2 상위 경로 추종 과제에서 별도로 비교할 항목이다.

다음 비교는 **같은 물리·명령·시드의 heldout**에서 보상만 바꾼 teacher를
IK/`s51`과 짝지어 본다. 먼저 문제 구간을 슬립·침하·조향 대기·속도오차로
분리하고, 회복 가능한 구간의 속도·요 오차 이득과 회복 불가 구간의
고착/침하 악화를 함께 측정한다. ERNEST식 지형별 replay 통합은
모래 단일 목표에서 지형별 성공 정책을 확보한 뒤 검토한다.
