cmwcmw57/pi-backup/ksrc/sysid_logs/20261013_093046_drive_m234/report.txt

== 구동 분석: sysid_logs/20261013_093046_drive_m234
   시험 156개, 반복 5, 움직인 모터 [2, 3, 4], 2026-10-13 09:30:46 ~ 2026-10-13 09:38:58

[측정 조건]
  [PASS] 샘플 타이밍: late_max 1 us (허용 100)
  REF(duty 400) 평균속도 순서대로: 3.827 3.869 3.874 3.876 3.873 3.868 3.871 3.879 3.888 3.878 3.879 3.892 3.893 3.881 3.878 3.890 rad/s
  그때 서보 전압: 11.7 11.7 11.7 11.7 11.6 11.6 11.6 11.6 11.6 11.6 11.6 11.6 11.6 11.6 11.6 11.6 V
  [PASS] 배터리·온도 표류 (REF): 처음 대비 +1.65%, 범위 1.74% (허용 2%)

[D1] duty → 정상속도 (각 반복 따로 직선 피팅: ω = k·(duty − 데드밴드))
  duty       M2 (평균±표준편차)       M3 (평균±표준편차)       M4 (평균±표준편차)
  -799    -7.238 ± 0.266        -7.824 ± 0.043        -7.425 ± 0.007    
    ! 튀는 반복: duty -799 M2 반복 2: -7.623 (나머지 중앙값 -7.080)
  -400    -3.942 ± 0.043        -3.982 ± 0.006        -3.858 ± 0.007    
  -200    -1.964 ± 0.009        -1.971 ± 0.003        -1.890 ± 0.003    
  -160    -1.557 ± 0.012        -1.569 ± 0.010        -1.494 ± 0.011    
  -120    -1.154 ± 0.010        -1.168 ± 0.004        -1.089 ± 0.020    
   -80    -0.744 ± 0.002        -0.755 ± 0.008        -0.675 ± 0.023    
   -40    -0.335 ± 0.004        -0.291 ± 0.007        -0.178 ± 0.011    
   +40    +0.265 ± 0.005        +0.318 ± 0.009        +0.076 ± 0.105    
    ! 튀는 반복: duty 40 M4 반복 1: +0.191 (나머지 중앙값 +0.000)
    ! 튀는 반복: duty 40 M4 반복 2: +0.191 (나머지 중앙값 +0.000)
   +80    +0.727 ± 0.015        +0.752 ± 0.009        +0.659 ± 0.004    
  +120    +1.154 ± 0.005        +1.163 ± 0.009        +1.050 ± 0.007    
  +160    +1.558 ± 0.004        +1.572 ± 0.008        +1.432 ± 0.006    
  +200    +1.963 ± 0.011        +1.964 ± 0.008        +1.815 ± 0.009    
  +300    +2.968 ± 0.007        +2.965 ± 0.010        +2.765 ± 0.018    
  +400    +3.961 ± 0.016        +3.956 ± 0.006        +3.703 ± 0.020    
  +500    +4.942 ± 0.019        +4.940 ± 0.008        +4.640 ± 0.036    
  +600    +5.875 ± 0.036        +5.909 ± 0.010        +5.554 ± 0.050    
  +700    +6.838 ± 0.054        +6.888 ± 0.010        +6.495 ± 0.051    
  +799    +7.598 ± 0.055        +7.806 ± 0.013        +7.415 ± 0.032    
  모터  ω0 전진 (duty 799) rad/s     ω0 후진               데드밴드 전진 duty   데드밴드 후진    비선형(최대)
  M2   7.753 ± 0.020 (n=5)   7.354 ± 0.270 (n=5)   2.8 ± 1.2 (n=5)   8.9 ± 7.0 (n=5)   2.6% / 4.3%
  M3   7.862 ± 0.008 (n=5)   7.849 ± 0.045 (n=5)   2.2 ± 0.5 (n=5)   1.3 ± 0.7 (n=5)   0.9% / 1.0%
  M4   7.429 ± 0.014 (n=5)   7.481 ± 0.008 (n=5)   7.3 ± 1.1 (n=5)   1.3 ± 1.4 (n=5)   1.1% / 1.7%
  ω0 평균 7.681 rad/s = 바퀴 0.365 m/s (반경 0.047503).  모터 개체차 M2 +0.9%, M3 +2.3%, M4 -3.3%
  [PASS] M2 ω0 fwd 반복성: 95%CI ±0.020 (허용 ±0.078)
  [PASS] M2 데드밴드 fwd 반복성: 95%CI ±1.2 duty (허용 ±5)
  [FAIL] M2 ω0 rev 반복성: 95%CI ±0.270 (허용 ±0.074)
  [FAIL] M2 데드밴드 rev 반복성: 95%CI ±7.0 duty (허용 ±5)
  [PASS] M3 ω0 fwd 반복성: 95%CI ±0.008 (허용 ±0.079)
  [PASS] M3 데드밴드 fwd 반복성: 95%CI ±0.5 duty (허용 ±5)
  [PASS] M3 ω0 rev 반복성: 95%CI ±0.045 (허용 ±0.078)
  [PASS] M3 데드밴드 rev 반복성: 95%CI ±0.7 duty (허용 ±5)
  [PASS] M4 ω0 fwd 반복성: 95%CI ±0.014 (허용 ±0.074)
  [PASS] M4 데드밴드 fwd 반복성: 95%CI ±1.1 duty (허용 ±5)
  [PASS] M4 ω0 rev 반복성: 95%CI ±0.008 (허용 ±0.075)
  [PASS] M4 데드밴드 rev 반복성: 95%CI ±1.4 duty (허용 ±5)
  #9 정상상태 속도 잡음 (20 ms 창): 중앙값 0.0188 rad/s  (1틱 양자화만이면 ~0.0153, 최대 0.0375)

[D2] 계단 응답 (위치 궤적에 1차 + 지연 피팅, 반복·모터별)
  0 200 100 700     
     M2  τ 42.0 ± 4.3 ms (n=5)   지연 0.2 ± 0.6 ms (n=5)   끝속도 +1.950   피팅잔차 0.034 rad/s
     M3  τ 36.4 ± 4.3 ms (n=5)   지연 1.4 ± 1.7 ms (n=5)   끝속도 +1.980   피팅잔차 0.036 rad/s
     M4  τ 33.6 ± 3.5 ms (n=5)   지연 2.5 ± 2.2 ms (n=5)   끝속도 +1.856   피팅잔차 0.039 rad/s
  0 400 100 700     
     M2  τ 40.7 ± 0.0 ms (n=5)   지연 0.2 ± 0.3 ms (n=5)   끝속도 +3.971   피팅잔차 0.040 rad/s
     M3  τ 39.3 ± 1.2 ms (n=5)   지연 0.5 ± 0.4 ms (n=5)   끝속도 +3.963   피팅잔차 0.040 rad/s
     M4  τ 37.1 ± 0.9 ms (n=5)   지연 0.5 ± 0.4 ms (n=5)   끝속도 +3.732   피팅잔차 0.042 rad/s
  0 799 100 700     
     M2  τ 41.1 ± 3.0 ms (n=5)   지연 0.4 ± 0.5 ms (n=5)   끝속도 +7.609   피팅잔차 0.084 rad/s
     M3  τ 41.6 ± 1.0 ms (n=5)   지연 0.3 ± 0.6 ms (n=5)   끝속도 +7.617   피팅잔차 0.081 rad/s
     M4  τ 36.7 ± 3.8 ms (n=5)   지연 1.0 ± 1.5 ms (n=5)   끝속도 +7.310   피팅잔차 0.068 rad/s
  799 0 100 1200    
     M2  τ 33.8 ± 1.6 ms (n=5)   지연 7.6 ± 1.4 ms (n=5)   끝속도 +0.000   피팅잔차 0.091 rad/s
     M3  τ 31.7 ± 1.7 ms (n=5)   지연 7.5 ± 1.3 ms (n=5)   끝속도 +0.000   피팅잔차 0.089 rad/s
     M4  τ 30.1 ± 1.2 ms (n=5)   지연 7.0 ± 0.8 ms (n=5)   끝속도 +0.000   피팅잔차 0.082 rad/s
  400 -400 100 1200 
     M2  τ 38.7 ± 1.6 ms (n=5)   지연 0.5 ± 0.8 ms (n=5)   끝속도 -3.973   피팅잔차 0.050 rad/s
     M3  τ 39.3 ± 1.2 ms (n=5)   지연 0.6 ± 0.5 ms (n=5)   끝속도 -3.965   피팅잔차 0.062 rad/s
     M4  τ 43.1 ± 1.0 ms (n=5)   지연 0.0 ± 0.0 ms (n=5)   끝속도 -3.841   피팅잔차 0.119 rad/s
  0 -799 100 700    
     M2  τ 41.9 ± 1.6 ms (n=5)   지연 0.4 ± 0.3 ms (n=5)   끝속도 -7.642   피팅잔차 0.105 rad/s
     M3  τ 41.0 ± 0.8 ms (n=5)   지연 0.4 ± 0.5 ms (n=5)   끝속도 -7.618   피팅잔차 0.071 rad/s
     M4  τ 44.1 ± 2.6 ms (n=5)   지연 0.1 ± 0.3 ms (n=5)   끝속도 -7.397   피팅잔차 0.124 rad/s
  [PASS] M2 τ (0 400 100 700) 반복성: 40.7 ms, 95%CI ±0.0 (허용 ±4.1)
  [PASS] M2 지연 반복성: 0.2 ms, 95%CI ±0.3 (허용 ±2)
  [PASS] M3 τ (0 400 100 700) 반복성: 39.3 ms, 95%CI ±1.2 (허용 ±3.9)
  [PASS] M3 지연 반복성: 0.5 ms, 95%CI ±0.4 (허용 ±2)
  [PASS] M4 τ (0 400 100 700) 반복성: 37.1 ms, 95%CI ±0.9 (허용 ±3.7)
  [PASS] M4 지연 반복성: 0.5 ms, 95%CI ±0.4 (허용 ±2)
  τ 비교 (모터 평균, 0→400 대비):
     0 200 100 700      τ   37.4 ms  ×0.96
     0 400 100 700      τ   39.0 ms  ×1.00
     0 799 100 700      τ   39.8 ms  ×1.02
     799 0 100 1200     τ   31.9 ms  ×0.82  ← 제동 (MDD3A 브레이크)
     400 -400 100 1200  τ   40.4 ms  ×1.03  ← 역전
     0 -799 100 700     τ   42.3 ms  ×1.08
  → 반사관성 J = τ·D: D(토크-속도 기울기)를 D5 에서 재면 J = 0.0390·D  (D=0.246 이면 9.60e-03 kg·m², 지금 시뮬 armature 1.5e-3)
  D1 정상속도 vs D2 끝속도 (같은 duty, 다른 시험):
  [FAIL] 정상속도 일치 duty +200: 최대 차이 2.3% (허용 2%)
  [PASS] 정상속도 일치 duty +400: 최대 차이 0.8% (허용 2%)
  [FAIL] 정상속도 일치 duty +799: 최대 차이 2.4% (허용 2%)
  [FAIL] 정상속도 일치 duty -799: 최대 차이 5.6% (허용 2%)

[D3] 저속 램프: 기동 duty(정지→회전) / 정지 duty(회전→정지)
  기동 = 확실히 돈 뒤(50 ms 창 속도 > 문턱이 50 ms) 거슬러 올라가 엔코더가 처음 움직인 샘플의 duty − 램프기울기×지연
  정지 = 엔코더가 50 ms 동안 안 움직이기 시작한 샘플의 duty + 램프기울기×(지연+τ).  기동을 D1 데드밴드(운동마찰)와 비교한다.
  -150 0 2000 2000 RAMP  정지 duty: M2 32.3 ± 1.4 (n=5)   M3 32.4 ± 3.1 (n=5)   M4 35.8 ± 1.2 (n=5)
  0 -150 2000 2000 RAMP  기동 duty: M2 41.2 ± 2.8 (n=5)   M3 36.6 ± 2.4 (n=5)   M4 44.2 ± 1.6 (n=5)
  [PASS] M2 기동 duty (-150) 반복성: 95%CI ±2.8 (허용 ±6)
  [PASS] M3 기동 duty (-150) 반복성: 95%CI ±2.4 (허용 ±6)
  [PASS] M4 기동 duty (-150) 반복성: 95%CI ±1.6 (허용 ±6)
  0 150 2000 2000 RAMP   기동 duty: M2 38.4 ± 2.6 (n=5)   M3 40.8 ± 1.0 (n=5)   M4 41.4 ± 8.4 (n=5)
  [PASS] M2 기동 duty (150) 반복성: 95%CI ±2.6 (허용 ±6)
  [PASS] M3 기동 duty (150) 반복성: 95%CI ±1.0 (허용 ±6)
  [FAIL] M4 기동 duty (150) 반복성: 95%CI ±8.4 (허용 ±6)
  150 0 2000 2000 RAMP   정지 duty: M2 32.7 ± 0.7 (n=5)   M3 30.2 ± 2.4 (n=5)   M4 34.4 ± 3.1 (n=5)
  M2 전진: 기동(정지마찰) 38.4 − D1 데드밴드(운동마찰) 2.8 = +35.6 duty → 정지마찰 있음 (시뮬 FF·마찰에 반영 검토)
  M2 후진: 기동(정지마찰) 41.2 − D1 데드밴드(운동마찰) 8.9 = +32.3 duty → 정지마찰 있음 (시뮬 FF·마찰에 반영 검토)
  M3 전진: 기동(정지마찰) 40.8 − D1 데드밴드(운동마찰) 2.2 = +38.6 duty → 정지마찰 있음 (시뮬 FF·마찰에 반영 검토)
  M3 후진: 기동(정지마찰) 36.6 − D1 데드밴드(운동마찰) 1.3 = +35.3 duty → 정지마찰 있음 (시뮬 FF·마찰에 반영 검토)
  M4 전진: 기동(정지마찰) 41.4 − D1 데드밴드(운동마찰) 7.3 = +34.1 duty → 정지마찰 있음 (시뮬 FF·마찰에 반영 검토)
  M4 후진: 기동(정지마찰) 44.2 − D1 데드밴드(운동마찰) 1.3 = +42.9 duty → 정지마찰 있음 (시뮬 FF·마찰에 반영 검토)

[검증] D1 표 + '0 400 100 700' 의 τ·지연만으로 만든 1차 모델이 피팅에 안 쓴 시험을 맞히는가
  오차 = 모델 vs 반복 평균 궤적 RMS (10 ms 창 속도).  잡음 바닥 = 반복끼리의 RMS 편차.
  PASS 조건: 오차 ≤ max(2 × 잡음 바닥, 최고속도의 3%)
  [FAIL] 모델 검증 D2 0 -799 100 700: 오차/허용 rad/s: M2 0.329/0.231✗  M3 0.213/0.230  M4 0.145/0.223
  [PASS] 모델 검증 D2 0 200 100 700: 오차/허용 rad/s: M2 0.021/0.080  M3 0.026/0.072  M4 0.045/0.087
  [PASS] 모델 검증 D2 0 799 100 700: 오차/허용 rad/s: M2 0.062/0.230  M3 0.205/0.256  M4 0.102/0.221
  [PASS] 모델 검증 D2 400 -400 100 1200: 오차/허용 rad/s: M2 0.071/0.120  M3 0.056/0.120  M4 0.091/0.117
  [PASS] 모델 검증 D2 799 0 100 1200: 오차/허용 rad/s: M2 0.111/0.233  M3 0.113/0.226  M4 0.082/0.218
  [FAIL] 모델 검증 D3 -150 0 2000 2000 RAMP: 오차/허용 rad/s: M2 0.077/0.062✗  M3 0.074/0.061✗  M4 0.061/0.064
  [FAIL] 모델 검증 D3 0 -150 2000 2000 RAMP: 오차/허용 rad/s: M2 0.099/0.073✗  M3 0.075/0.066✗  M4 0.063/0.073
  [FAIL] 모델 검증 D3 0 150 2000 2000 RAMP: 오차/허용 rad/s: M2 0.073/0.066✗  M3 0.095/0.059✗  M4 0.042/0.106
  [FAIL] 모델 검증 D3 150 0 2000 2000 RAMP: 오차/허용 rad/s: M2 0.067/0.060✗  M3 0.076/0.060✗  M4 0.061/0.064

== 종합: 확인 39개 중 FAIL 11개
   FAIL M2 ω0 rev 반복성: 95%CI ±0.270 (허용 ±0.074)
   FAIL M2 데드밴드 rev 반복성: 95%CI ±7.0 duty (허용 ±5)
   FAIL 정상속도 일치 duty +200: 최대 차이 2.3% (허용 2%)
   FAIL 정상속도 일치 duty +799: 최대 차이 2.4% (허용 2%)
   FAIL 정상속도 일치 duty -799: 최대 차이 5.6% (허용 2%)
   FAIL M4 기동 duty (150) 반복성: 95%CI ±8.4 (허용 ±6)
   FAIL 모델 검증 D2 0 -799 100 700: 오차/허용 rad/s: M2 0.329/0.231✗  M3 0.213/0.230  M4 0.145/0.223
   FAIL 모델 검증 D3 -150 0 2000 2000 RAMP: 오차/허용 rad/s: M2 0.077/0.062✗  M3 0.074/0.061✗  M4 0.061/0.064
   FAIL 모델 검증 D3 0 -150 2000 2000 RAMP: 오차/허용 rad/s: M2 0.099/0.073✗  M3 0.075/0.066✗  M4 0.063/0.073
   FAIL 모델 검증 D3 0 150 2000 2000 RAMP: 오차/허용 rad/s: M2 0.073/0.066✗  M3 0.095/0.059✗  M4 0.042/0.106
   FAIL 모델 검증 D3 150 0 2000 2000 RAMP: 오차/허용 rad/s: M2 0.067/0.060✗  M3 0.076/0.060✗  M4 0.061/0.064
