cmwcmw57/pi-backup/ksrc/sysid_logs/20261013_095438_steer_servo1/report.txt

== 조향 분석: sysid_logs/20261013_095438_steer_servo1   (STEP 78개)

[ACC 0]  계단크기   10→90% ms            최고속(위치미분) 도/s    도달 ms               오버슈트 도
          80°   475 ± 1 (n=12)      194 ± 3 (n=12)          823 ± 1 (n=12)      0.00 ± 0.00 (n=12)
          45°   356 ± 3 (n=6)       145 ± 6 (n=6)           606 ± 4 (n=6)       0.00 ± 0.00 (n=6)
          15°   207 ± 1 (n=6)       81 ± 5 (n=6)            338 ± 2 (n=6)       0.00 ± 0.00 (n=6)
           5°   128 ± 8 (n=6)       44 ± 3 (n=6)            185 ± 4 (n=6)       0.00 ± 0.00 (n=6)
           3°   96 ± 11 (n=4)       36 ± 4 (n=6)            132 ± 4 (n=6)       0.00 ± 0.00 (n=6)  ! 90% 못 감 2회
  사다리꼴 피팅: 가속 439 도/s² = 7.7 rad/s², 최고속 170 도/s = 2.97 rad/s, 잔차 5.1 ms
  [PASS] ACC 0 80° 10→90% 반복성: 475 ms, 95%CI ±1 (허용 ±48)
  [PASS] ACC 0 사다리꼴 모델 적합: 계단 크기 5개에 잔차 5.1 ms
  궤적 피팅 가속도 443 도/s² = 7.7 rad/s², 최고속 170 도/s 고정
  시작 지연 L (궤적 피팅, 명령 송신 → 움직임 시작): 33.9 ± 1.2 ms (n=36)   (펌웨어 '시작 지연' 줄은 0.5도 도달 시각이라 가속 제한이 섞임)
  [PASS] ACC 0 궤적 모델 적합 (RAW): RMS/허용 도: 80° 0.14/2.40  45° 0.10/1.35  15° 0.06/0.50  5° 0.06/0.50  3° 0.05/0.50
  [PASS] ACC 0 시작 지연 반복성: 95%CI ±1.2 ms (허용 ±2)

[ACC 50]  계단크기   10→90% ms            최고속(위치미분) 도/s    도달 ms               오버슈트 도
          80°   475 ± 2 (n=12)      193 ± 3 (n=12)          823 ± 2 (n=12)      0.00 ± 0.00 (n=12)
          45°   356 ± 3 (n=6)       146 ± 6 (n=6)           606 ± 3 (n=6)       0.00 ± 0.00 (n=6)
          15°   208 ± 1 (n=6)       79 ± 4 (n=6)            339 ± 2 (n=6)       0.00 ± 0.00 (n=6)
           5°   127 ± 7 (n=6)       44 ± 3 (n=6)            185 ± 3 (n=6)       0.00 ± 0.00 (n=6)
           3°   99 ± 9 (n=6)        34 ± 0 (n=6)            132 ± 5 (n=6)       0.00 ± 0.00 (n=6)
  사다리꼴 피팅: 가속 439 도/s² = 7.7 rad/s², 최고속 170 도/s = 2.97 rad/s, 잔차 5.6 ms   (Feetech 단위 100 step/s² 가정 시 ACC 50 = 439 도/s²)
  [PASS] ACC 50 80° 10→90% 반복성: 475 ms, 95%CI ±2 (허용 ±48)
  [PASS] ACC 50 사다리꼴 모델 적합: 계단 크기 5개에 잔차 5.6 ms
  궤적 피팅 가속도 443 도/s² = 7.7 rad/s², 최고속 170 도/s 고정
  시작 지연 L (궤적 피팅, 명령 송신 → 움직임 시작): 33.7 ± 1.1 ms (n=36)   (펌웨어 '시작 지연' 줄은 0.5도 도달 시각이라 가속 제한이 섞임)
  [PASS] ACC 50 궤적 모델 적합 (RAW): RMS/허용 도: 80° 0.14/2.40  45° 0.10/1.35  15° 0.07/0.50  5° 0.06/0.50  3° 0.04/0.50
  [PASS] ACC 50 시작 지연 반복성: 95%CI ±1.1 ms (허용 ±2)
  궤적 72개 → steer_traj.npz (시뮬에 같은 계단 넣어 비교용: t s, 각도 도, 속도, 부하)

[ACC 50 vs 0]  (시뮬: 최고속 5.45 rad/s = 312 도/s, 가속 제한 없음)
  80° 10→90%: ACC50 475 ms, ACC0 475 ms, 차이 +0 ± 2 ms → 차이 구별 안 됨
  80° 도달: ACC50 823 ms, ACC0 823 ms, 차이 +0 ± 2 ms → 차이 구별 안 됨

== 종합: 확인 8개 중 FAIL 0개
   전부 PASS: 반복성·측정조건·모델 검증 통과.  summary.json 값을 시뮬에 반영해도 된다.
