cmwcmw57/pi-backup/ksrc/sysid_logs/20261013_100010_steer_servo1/report.txt

== 조향 분석: sysid_logs/20261013_100010_steer_servo1   (STEP 52개)

[ACC 100]  계단크기   10→90% ms            최고속(위치미분) 도/s    도달 ms               오버슈트 도
          90°   503 ± 2 (n=8)       206 ± 0 (n=8)           874 ± 2 (n=8)       0.00 ± 0.00 (n=8)
          45°   356 ± 5 (n=4)       141 ± 8 (n=4)           606 ± 5 (n=4)       0.00 ± 0.00 (n=4)
          15°   208 ± 2 (n=4)       80 ± 6 (n=4)            339 ± 2 (n=4)       0.00 ± 0.00 (n=4)
           5°   126 ± 13 (n=4)      45 ± 6 (n=4)            186 ± 5 (n=4)       0.00 ± 0.00 (n=4)
           3°   99 ± 14 (n=4)       34 ± 1 (n=4)            133 ± 6 (n=4)       0.00 ± 0.00 (n=4)
  사다리꼴 피팅: 가속 439 도/s² = 7.7 rad/s², 최고속 190 도/s = 3.32 rad/s, 잔차 5.5 ms   (Feetech 단위 100 step/s² 가정 시 ACC 100 = 879 도/s²)
  [PASS] ACC 100 90° 10→90% 반복성: 503 ms, 95%CI ±2 (허용 ±50)
  [PASS] ACC 100 사다리꼴 모델 적합: 계단 크기 5개에 잔차 5.5 ms
  궤적 피팅 가속도 443 도/s² = 7.7 rad/s², 최고속 190 도/s 고정
  시작 지연 L (궤적 피팅, 명령 송신 → 움직임 시작): 34.5 ± 1.4 ms (n=24)   (펌웨어 '시작 지연' 줄은 0.5도 도달 시각이라 가속 제한이 섞임)
  [PASS] ACC 100 궤적 모델 적합 (RAW): RMS/허용 도: 90° 0.10/2.70  45° 0.10/1.35  15° 0.06/0.50  5° 0.07/0.50  3° 0.04/0.50
  [PASS] ACC 100 시작 지연 반복성: 95%CI ±1.4 ms (허용 ±2)

[ACC 254]  계단크기   10→90% ms            최고속(위치미분) 도/s    도달 ms               오버슈트 도
          90°   502 ± 2 (n=8)       204 ± 2 (n=8)           874 ± 2 (n=8)       0.00 ± 0.00 (n=8)
          45°   356 ± 5 (n=4)       143 ± 7 (n=4)           606 ± 5 (n=4)       0.00 ± 0.00 (n=4)
          15°   208 ± 2 (n=4)       79 ± 6 (n=4)            339 ± 4 (n=4)       0.00 ± 0.00 (n=4)
           5°   127 ± 12 (n=4)      45 ± 6 (n=4)            185 ± 5 (n=4)       0.00 ± 0.00 (n=4)
           3°   100 ± 13 (n=4)      36 ± 7 (n=4)            132 ± 6 (n=4)       0.00 ± 0.00 (n=4)
  사다리꼴 피팅: 가속 439 도/s² = 7.7 rad/s², 최고속 190 도/s = 3.32 rad/s, 잔차 5.8 ms   (Feetech 단위 100 step/s² 가정 시 ACC 254 = 2232 도/s²)
  [PASS] ACC 254 90° 10→90% 반복성: 502 ms, 95%CI ±2 (허용 ±50)
  [PASS] ACC 254 사다리꼴 모델 적합: 계단 크기 5개에 잔차 5.8 ms
  궤적 피팅 가속도 443 도/s² = 7.7 rad/s², 최고속 190 도/s 고정
  시작 지연 L (궤적 피팅, 명령 송신 → 움직임 시작): 34.4 ± 1.3 ms (n=24)   (펌웨어 '시작 지연' 줄은 0.5도 도달 시각이라 가속 제한이 섞임)
  [PASS] ACC 254 궤적 모델 적합 (RAW): RMS/허용 도: 90° 0.10/2.70  45° 0.10/1.35  15° 0.06/0.50  5° 0.07/0.50  3° 0.04/0.50
  [PASS] ACC 254 시작 지연 반복성: 95%CI ±1.3 ms (허용 ±2)
  궤적 48개 → steer_traj.npz (시뮬에 같은 계단 넣어 비교용: t s, 각도 도, 속도, 부하)

== 종합: 확인 8개 중 FAIL 0개
   전부 PASS: 반복성·측정조건·모델 검증 통과.  summary.json 값을 시뮬에 반영해도 된다.
