cmwcmw57/pi-backup/ksrc/sysid_logs/20261013_100707_steer_servo2/report.txt

== 조향 분석: sysid_logs/20261013_100707_steer_servo2   (STEP 26개)

[ACC 50]  계단크기   10→90% ms            최고속(위치미분) 도/s    도달 ms               오버슈트 도
          90°   502 ± 4 (n=7)       205 ± 1 (n=7)           873 ± 4 (n=6)       0.00 ± 0.00 (n=6)
          45°   355 ± 6 (n=4)       143 ± 6 (n=4)           605 ± 6 (n=4)       0.00 ± 0.00 (n=4)
          15°   206 ± 6 (n=4)       81 ± 8 (n=4)            338 ± 6 (n=4)       0.00 ± 0.00 (n=4)
           5°   126 ± 15 (n=4)      45 ± 6 (n=4)            183 ± 7 (n=4)       0.00 ± 0.00 (n=4)
           3°   95 ± 140 (n=2)      34 ± 0 (n=4)            130 ± 8 (n=4)       0.00 ± 0.00 (n=4)  ! 90% 못 감 2회
  사다리꼴 피팅: 가속 439 도/s² = 7.7 rad/s², 최고속 190 도/s = 3.32 rad/s, 잔차 3.8 ms   (Feetech 단위 100 step/s² 가정 시 ACC 50 = 439 도/s²)
  [PASS] ACC 50 90° 10→90% 반복성: 502 ms, 95%CI ±4 (허용 ±50)
  [PASS] ACC 50 사다리꼴 모델 적합: 계단 크기 5개에 잔차 3.8 ms
  궤적 피팅 가속도 443 도/s² = 7.7 rad/s², 최고속 190 도/s 고정
  시작 지연 L (궤적 피팅, 명령 송신 → 움직임 시작): 34.0 ± 1.4 ms (n=23)   (펌웨어 '시작 지연' 줄은 0.5도 도달 시각이라 가속 제한이 섞임)
  [PASS] ACC 50 궤적 모델 적합 (RAW): RMS/허용 도: 90° 0.09/2.70  45° 0.10/1.35  15° 0.09/0.50  5° 0.07/0.50  3° 0.07/0.50
  [PASS] ACC 50 시작 지연 반복성: 95%CI ±1.4 ms (허용 ±2)
  궤적 23개 → steer_traj.npz (시뮬에 같은 계단 넣어 비교용: t s, 각도 도, 속도, 부하)

== 종합: 확인 4개 중 FAIL 0개
   전부 PASS: 반복성·측정조건·모델 검증 통과.  summary.json 값을 시뮬에 반영해도 된다.
