cmwcmw57/pi-backup/ksrc/sysid_logs/20261013_101113_steer_servo4/report.txt

== 조향 분석: sysid_logs/20261013_101113_steer_servo4   (STEP 26개)

[ACC 50]  계단크기   10→90% ms            최고속(위치미분) 도/s    도달 ms               오버슈트 도
          90°   501 ± 2 (n=8)       204 ± 2 (n=8)           872 ± 2 (n=8)       0.00 ± 0.00 (n=8)
          45°   357 ± 6 (n=4)       143 ± 13 (n=4)          606 ± 6 (n=4)       0.00 ± 0.00 (n=4)
          15°   206 ± 1 (n=4)       79 ± 6 (n=4)            338 ± 5 (n=4)       0.00 ± 0.00 (n=4)
           5°   124 ± 14 (n=4)      47 ± 7 (n=4)            182 ± 8 (n=4)       0.00 ± 0.00 (n=4)
           3°   98 ± 12 (n=4)       38 ± 8 (n=4)            129 ± 6 (n=4)       0.00 ± 0.00 (n=4)
  사다리꼴 피팅: 가속 439 도/s² = 7.7 rad/s², 최고속 190 도/s = 3.32 rad/s, 잔차 4.6 ms   (Feetech 단위 100 step/s² 가정 시 ACC 50 = 439 도/s²)
  [PASS] ACC 50 90° 10→90% 반복성: 501 ms, 95%CI ±2 (허용 ±50)
  [PASS] ACC 50 사다리꼴 모델 적합: 계단 크기 5개에 잔차 4.6 ms
  궤적 피팅 가속도 443 도/s² = 7.7 rad/s², 최고속 190 도/s 고정
  시작 지연 L (궤적 피팅, 명령 송신 → 움직임 시작): 34.1 ± 1.3 ms (n=24)   (펌웨어 '시작 지연' 줄은 0.5도 도달 시각이라 가속 제한이 섞임)
  [PASS] ACC 50 궤적 모델 적합 (RAW): RMS/허용 도: 90° 0.10/2.70  45° 0.11/1.35  15° 0.09/0.50  5° 0.09/0.50  3° 0.07/0.50
  [PASS] ACC 50 시작 지연 반복성: 95%CI ±1.3 ms (허용 ±2)
  궤적 24개 → steer_traj.npz (시뮬에 같은 계단 넣어 비교용: t s, 각도 도, 속도, 부하)

== 종합: 확인 4개 중 FAIL 0개
   전부 PASS: 반복성·측정조건·모델 검증 통과.  summary.json 값을 시뮬에 반영해도 된다.
