cmwcmw57/pi-backup/ksrc/sysid_logs/20261013_101541_steersmall_servo1/report.txt

== 조향 작은 계단 분석: sysid_logs/20261013_101541_steersmall_servo1   (RAW STEP 124개, 1 스텝 = 0.088도)
  서보 레지스터: 가속도 50, 데드존 CW 1 / CCW 1 스텝 (= 0.088 / 0.088도)

[S3] 히스테리시스: 0도에 -5 쪽 / +5 쪽에서 다가가 멈춘 위치 (서보 출력축 엔코더 기준)
  반복 0: 아래에서 -0.205, 위에서 +0.090  → 차이 +0.295도
  반복 1: 아래에서 -0.260, 위에서 +0.090  → 차이 +0.350도
  반복 2: 아래에서 -0.260, 위에서 +0.090  → 차이 +0.350도
  반복 3: 아래에서 -0.260, 위에서 +0.260  → 차이 +0.520도
  반복 4: 아래에서 -0.260, 위에서 +0.090  → 차이 +0.350도
  히스테리시스 0.373 ± 0.106도 (n=5) → 있음: 데드존 ≈ ±0.19도
  [FAIL] 히스테리시스 반복성: 95%CI ±0.106도 (허용 ±0.1)

[S2] 작은 계단: 0 에서 ±A 로 명령 (out 만).  움직임 = 최종이 시작에서 1 스텝 이상
   A 도     움직인 비율     |최종−목표| 중앙값 도 (움직인 것만)
   0.10     0/ 6 (  0%)     nan
   0.20     1/ 8 ( 12%)     0.110
   0.30     4/10 ( 40%)     0.210
   0.50    10/10 (100%)     0.105
   1.00    10/10 (100%)     0.210
   1.50    10/10 (100%)     0.180
  움직이기 시작하는 최소 명령 (반복마다, 그 이상 전부 움직인 가장 작은 A): 0.50 ± 0.00도 (n=5)
  → 시뮬 조향에 명령 데드밴드 ≈ 0.25~0.50도 (A 격자 사이에 있음)
  [PASS] 최소 명령 반복성: 95%CI ±0.00도 (허용 ±0.2)
  주의: 서보 엔코더는 출력축에 있어 서보 바깥(혼·커플링·조향 링크) 놀음은 여기 안 보인다.
        바퀴 쪽 놀음은 손으로 조향축을 좌우로 밀며 P 명령 각도가 안 변하는 범위를 따로 본다.

== 종합: 확인 2개 중 FAIL 1개
   FAIL 히스테리시스 반복성: 95%CI ±0.106도 (허용 ±0.1)
