cmwcmw57/pi-backup/ksrc/sysid_logs/20261013_102224_drive/report.txt

== 구동 분석: sysid_logs/20261013_102224_drive
   시험 156개, 반복 5, 움직인 모터 [1, 2, 3, 4], 2026-10-13 10:22:24 ~ 2026-10-13 10:31:45

[측정 조건]
  [PASS] 샘플 타이밍: late_max 1 us (허용 100)
  REF(duty 400) 평균속도 순서대로: 3.848 3.840 3.841 3.841 3.836 3.836 3.836 3.838 3.837 3.839 3.829 3.828 3.836 3.822 3.822 3.828 rad/s
  그때 서보 전압: 11.3 11.3 11.3 11.3 11.3 11.3 11.3 11.3 11.3 11.2 11.2 11.2 11.2 11.2 11.2 11.2 V
  [PASS] 배터리·온도 표류 (REF): 처음 대비 -0.53%, 범위 0.68% (허용 2%)

[D1] duty → 정상속도 (각 반복 따로 직선 피팅: ω = k·(duty − 데드밴드))
  duty       M1 (평균±표준편차)       M2 (평균±표준편차)       M3 (평균±표준편차)       M4 (평균±표준편차)
  -799    -7.394 ± 0.085        -7.687 ± 0.012        -7.302 ± 0.095        -7.256 ± 0.070    
  -400    -3.862 ± 0.007        -3.883 ± 0.007        -3.894 ± 0.009        -3.747 ± 0.003    
  -200    -1.944 ± 0.007        -1.916 ± 0.006        -1.920 ± 0.005        -1.837 ± 0.007    
  -160    -1.556 ± 0.006        -1.515 ± 0.012        -1.524 ± 0.011        -1.453 ± 0.014    
  -120    -1.165 ± 0.005        -1.123 ± 0.004        -1.131 ± 0.005        -1.062 ± 0.021    
   -80    -0.772 ± 0.005        -0.719 ± 0.004        -0.728 ± 0.006        -0.664 ± 0.015    
   -40    -0.349 ± 0.003        -0.245 ± 0.137        -0.255 ± 0.002        -0.065 ± 0.090    
    ! 튀는 반복: duty -40 M2 반복 1: +0.000 (나머지 중앙값 -0.302)
    ! 튀는 반복: duty -40 M4 반복 0: -0.164 (나머지 중앙값 +0.000)
    ! 튀는 반복: duty -40 M4 반복 4: -0.163 (나머지 중앙값 +0.000)
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
     M2  τ 39.8 ± 1.0 ms (n=5)   지연 1.0 ± 0.0 ms (n=5)   끝속도 -3.856   피팅잔차 0.058 rad/s
     M3  τ 40.4 ± 0.8 ms (n=5)   지연 0.3 ± 0.3 ms (n=5)   끝속도 -3.882   피팅잔차 0.057 rad/s
     M4  τ 41.3 ± 1.0 ms (n=5)   지연 0.5 ± 0.6 ms (n=5)   끝속도 -3.753   피팅잔차 0.096 rad/s
  0 -799 100 700    
     M1  τ 37.4 ± 2.5 ms (n=5)   지연 0.8 ± 0.7 ms (n=5)   끝속도 -7.279   피팅잔차 0.070 rad/s
     M2  τ 44.4 ± 1.1 ms (n=5)   지연 0.4 ± 0.5 ms (n=5)   끝속도 -7.636   피팅잔차 0.098 rad/s
     M3  τ 41.3 ± 1.6 ms (n=5)   지연 0.2 ± 0.6 ms (n=5)   끝속도 -7.323   피팅잔차 0.086 rad/s
     M4  τ 43.7 ± 1.4 ms (n=5)   지연 0.4 ± 0.5 ms (n=5)   끝속도 -7.357   피팅잔차 0.092 rad/s
  [PASS] M1 τ (0 400 100 700) 반복성: 38.7 ms, 95%CI ±0.9 (허용 ±3.9)
  [PASS] M1 지연 반복성: 0.2 ms, 95%CI ±0.3 (허용 ±2)
  [PASS] M2 τ (0 400 100 700) 반복성: 42.8 ms, 95%CI ±1.7 (허용 ±4.3)
  [PASS] M2 지연 반복성: 0.5 ms, 95%CI ±0.6 (허용 ±2)
  [PASS] M3 τ (0 400 100 700) 반복성: 40.1 ms, 95%CI ±1.0 (허용 ±4.0)
  [PASS] M3 지연 반복성: 0.3 ms, 95%CI ±0.6 (허용 ±2)
  [PASS] M4 τ (0 400 100 700) 반복성: 37.9 ms, 95%CI ±0.0 (허용 ±3.8)
  [PASS] M4 지연 반복성: 0.4 ms, 95%CI ±0.5 (허용 ±2)
  τ 비교 (모터 평균, 0→400 대비):
     0 200 100 700      τ   40.0 ms  ×1.00
     0 400 100 700      τ   39.9 ms  ×1.00
     0 799 100 700      τ   41.7 ms  ×1.04
     799 0 100 1200     τ   32.5 ms  ×0.81  ← 제동 (MDD3A 브레이크)
     400 -400 100 1200  τ   39.0 ms  ×0.98  ← 역전
     0 -799 100 700     τ   41.7 ms  ×1.05
  → 반사관성 J = τ·D: D(토크-속도 기울기)를 D5 에서 재면 J = 0.0399·D  (D=0.246 이면 9.81e-03 kg·m², 지금 시뮬 armature 1.5e-3)
  D1 정상속도 vs D2 끝속도 (같은 duty, 다른 시험):
  [PASS] 정상속도 일치 duty +200: 최대 차이 1.5% (허용 2%)
  [PASS] 정상속도 일치 duty +400: 최대 차이 0.6% (허용 2%)
  [PASS] 정상속도 일치 duty +799: 최대 차이 0.6% (허용 2%)
  [PASS] 정상속도 일치 duty -799: 최대 차이 1.6% (허용 2%)

[D3] 저속 램프: 기동 duty(정지→회전) / 정지 duty(회전→정지)
  기동 = 확실히 돈 뒤(50 ms 창 속도 > 문턱이 50 ms) 거슬러 올라가 엔코더가 처음 움직인 샘플의 duty − 램프기울기×지연
  정지 = 엔코더가 50 ms 동안 안 움직이기 시작한 샘플의 duty + 램프기울기×(지연+τ).  기동을 D1 데드밴드(운동마찰)와 비교한다.
  -150 0 2000 2000 RAMP  정지 duty: M1 31.1 ± 1.8 (n=5)   M2 31.6 ± 1.4 (n=5)   M3 34.0 ± 1.2 (n=5)   M4 36.3 ± 2.3 (n=5)
  0 -150 2000 2000 RAMP  기동 duty: M1 43.6 ± 11.0 (n=5)   M2 52.0 ± 16.4 (n=5)   M3 35.4 ± 4.5 (n=5)   M4 42.0 ± 3.7 (n=5)
  [FAIL] M1 기동 duty (-150) 반복성: 95%CI ±11.0 (허용 ±6)
  [FAIL] M2 기동 duty (-150) 반복성: 95%CI ±16.4 (허용 ±6)
  [PASS] M3 기동 duty (-150) 반복성: 95%CI ±4.5 (허용 ±6)
  [PASS] M4 기동 duty (-150) 반복성: 95%CI ±3.7 (허용 ±6)
  0 150 2000 2000 RAMP   기동 duty: M1 35.2 ± 1.0 (n=5)   M2 37.6 ± 1.1 (n=5)   M3 41.4 ± 8.8 (n=5)   M4 47.0 ± 13.1 (n=5)
  [PASS] M1 기동 duty (150) 반복성: 95%CI ±1.0 (허용 ±6)
  [PASS] M2 기동 duty (150) 반복성: 95%CI ±1.1 (허용 ±6)
  [FAIL] M3 기동 duty (150) 반복성: 95%CI ±8.8 (허용 ±6)
  [FAIL] M4 기동 duty (150) 반복성: 95%CI ±13.1 (허용 ±6)
  150 0 2000 2000 RAMP   정지 duty: M1 31.1 ± 1.0 (n=5)   M2 35.0 ± 2.0 (n=5)   M3 32.4 ± 1.1 (n=5)   M4 36.7 ± 1.6 (n=5)
  M1 전진: 기동(정지마찰) 35.2 − D1 데드밴드(운동마찰) 9.6 = +25.5 duty → 정지마찰 있음 (시뮬 FF·마찰에 반영 검토)
  M1 후진: 기동(정지마찰) 43.6 − D1 데드밴드(운동마찰) 5.9 = +37.6 duty → 정지마찰 있음 (시뮬 FF·마찰에 반영 검토)
  M2 전진: 기동(정지마찰) 37.6 − D1 데드밴드(운동마찰) 1.9 = +35.7 duty → 정지마찰 있음 (시뮬 FF·마찰에 반영 검토)
  M2 후진: 기동(정지마찰) 52.0 − D1 데드밴드(운동마찰) 4.1 = +47.9 duty → 정지마찰 있음 (시뮬 FF·마찰에 반영 검토)
  M3 전진: 기동(정지마찰) 41.4 − D1 데드밴드(운동마찰) 3.9 = +37.5 duty → 정지마찰 있음 (시뮬 FF·마찰에 반영 검토)
  M3 후진: 기동(정지마찰) 35.4 − D1 데드밴드(운동마찰) 7.4 = +27.9 duty → 정지마찰 있음 (시뮬 FF·마찰에 반영 검토)
  M4 전진: 기동(정지마찰) 47.0 − D1 데드밴드(운동마찰) 6.4 = +40.6 duty → 정지마찰 있음 (시뮬 FF·마찰에 반영 검토)
  M4 후진: 기동(정지마찰) 42.0 − D1 데드밴드(운동마찰) 2.0 = +40.0 duty → 정지마찰 있음 (시뮬 FF·마찰에 반영 검토)

[검증] D1 표 + '0 400 100 700' 의 τ·지연만으로 만든 1차 모델이 피팅에 안 쓴 시험을 맞히는가
  오차 = 모델 vs 반복 평균 궤적 RMS (10 ms 창 속도).  잡음 바닥 = 반복끼리의 RMS 편차.
  PASS 조건: 오차 ≤ max(2 × 잡음 바닥, 최고속도의 3%)
  [PASS] 모델 검증 D2 0 -799 100 700: 오차/허용 rad/s: M1 0.116/0.220  M2 0.106/0.230  M3 0.059/0.221  M4 0.084/0.222
  [PASS] 모델 검증 D2 0 200 100 700: 오차/허용 rad/s: M1 0.015/0.066  M2 0.040/0.083  M3 0.017/0.062  M4 0.031/0.082
  [PASS] 모델 검증 D2 0 799 100 700: 오차/허용 rad/s: M1 0.108/0.220  M2 0.101/0.228  M3 0.084/0.223  M4 0.046/0.221
  [PASS] 모델 검증 D2 400 -400 100 1200: 오차/허용 rad/s: M1 0.066/0.119  M2 0.083/0.117  M3 0.048/0.118  M4 0.061/0.114
  [PASS] 모델 검증 D2 799 0 100 1200: 오차/허용 rad/s: M1 0.101/0.221  M2 0.075/0.229  M3 0.084/0.223  M4 0.074/0.219
  [FAIL] 모델 검증 D3 -150 0 2000 2000 RAMP: 오차/허용 rad/s: M1 0.078/0.064✗  M2 0.061/0.063  M3 0.067/0.061✗  M4 0.069/0.061✗
  [FAIL] 모델 검증 D3 0 -150 2000 2000 RAMP: 오차/허용 rad/s: M1 0.107/0.132  M2 0.110/0.170  M3 0.066/0.060✗  M4 0.055/0.076
  [FAIL] 모델 검증 D3 0 150 2000 2000 RAMP: 오차/허용 rad/s: M1 0.084/0.064✗  M2 0.064/0.071  M3 0.097/0.086✗  M4 0.046/0.138
  [FAIL] 모델 검증 D3 150 0 2000 2000 RAMP: 오차/허용 rad/s: M1 0.080/0.062✗  M2 0.065/0.063✗  M3 0.077/0.062✗  M4 0.050/0.064

== 종합: 확인 47개 중 FAIL 11개
   FAIL M1 ω0 rev 반복성: 95%CI ±0.089 (허용 ±0.075)
   FAIL M3 ω0 rev 반복성: 95%CI ±0.102 (허용 ±0.074)
   FAIL M4 ω0 rev 반복성: 95%CI ±0.076 (허용 ±0.073)
   FAIL M1 기동 duty (-150) 반복성: 95%CI ±11.0 (허용 ±6)
   FAIL M2 기동 duty (-150) 반복성: 95%CI ±16.4 (허용 ±6)
   FAIL M3 기동 duty (150) 반복성: 95%CI ±8.8 (허용 ±6)
   FAIL M4 기동 duty (150) 반복성: 95%CI ±13.1 (허용 ±6)
   FAIL 모델 검증 D3 -150 0 2000 2000 RAMP: 오차/허용 rad/s: M1 0.078/0.064✗  M2 0.061/0.063  M3 0.067/0.061✗  M4 0.069/0.061✗
   FAIL 모델 검증 D3 0 -150 2000 2000 RAMP: 오차/허용 rad/s: M1 0.107/0.132  M2 0.110/0.170  M3 0.066/0.060✗  M4 0.055/0.076
   FAIL 모델 검증 D3 0 150 2000 2000 RAMP: 오차/허용 rad/s: M1 0.084/0.064✗  M2 0.064/0.071  M3 0.097/0.086✗  M4 0.046/0.138
   FAIL 모델 검증 D3 150 0 2000 2000 RAMP: 오차/허용 rad/s: M1 0.080/0.062✗  M2 0.065/0.063✗  M3 0.077/0.062✗  M4 0.050/0.064
