cmwcmw57/pi-backup/ksrc/ros/rover_description/docs/camera_35deg_com.png

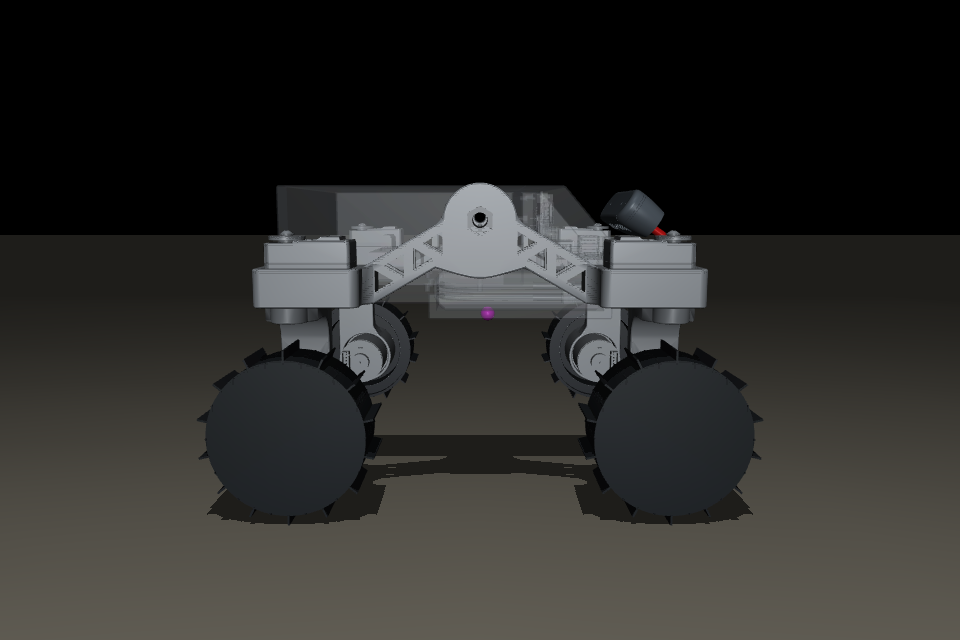
ksrc/ros/rover_description/docs/camera_35deg_com.png
