cmwcmw57/pi-backup/ksrc/ros/rover_description/docs/source_cad_preview.png

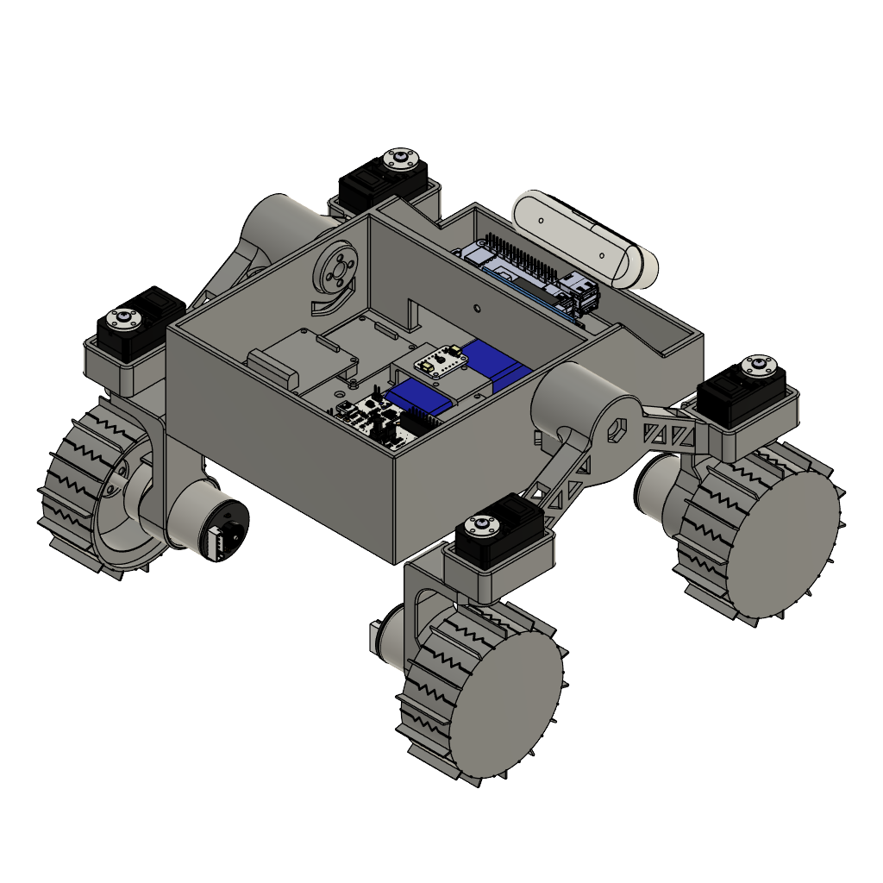
ksrc/ros/rover_description/docs/source_cad_preview.png
