cmwcmw57/pi-backup/ksrc/sim/rl/rover_model.png

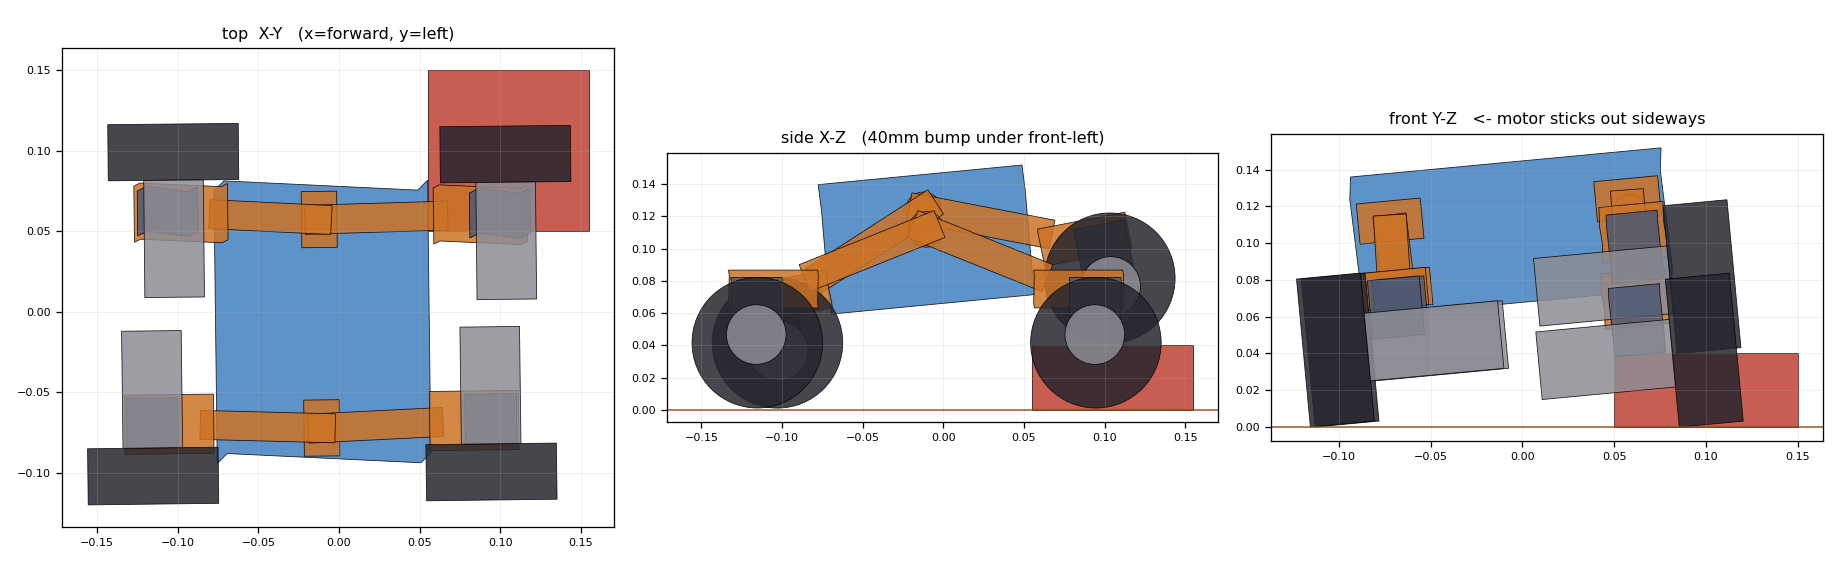
ksrc/sim/rl/rover_model.png
