cmwcmw57/pi-backup/ksrc/sim/rl/terrain_compare.png

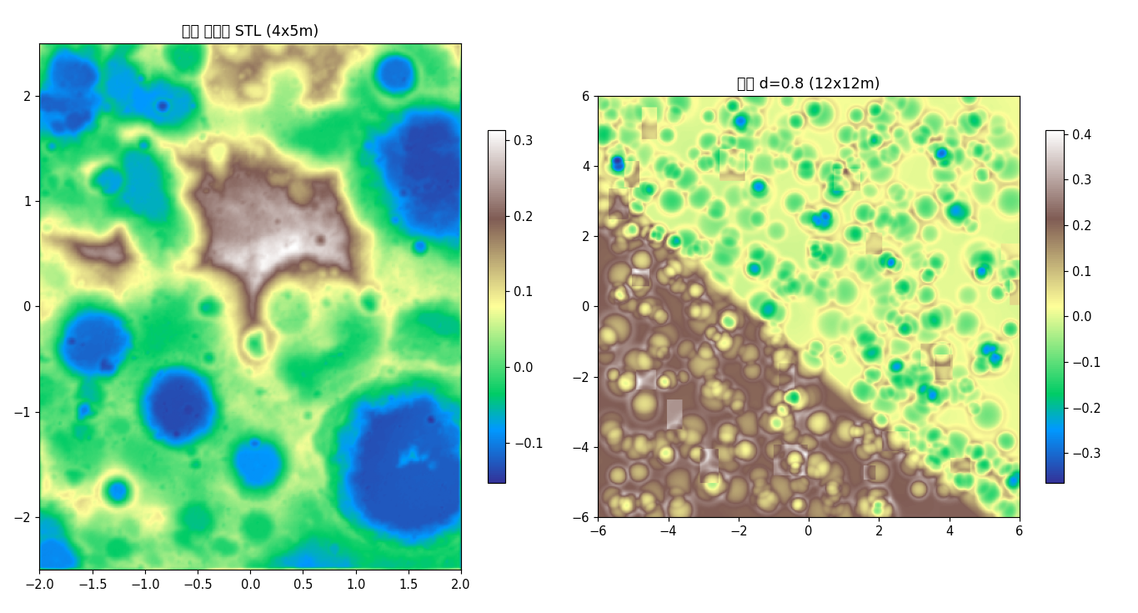
ksrc/sim/rl/terrain_compare.png
