cmwcmw57/pi-backup/ksrc_final_20261022/mission/preview.png

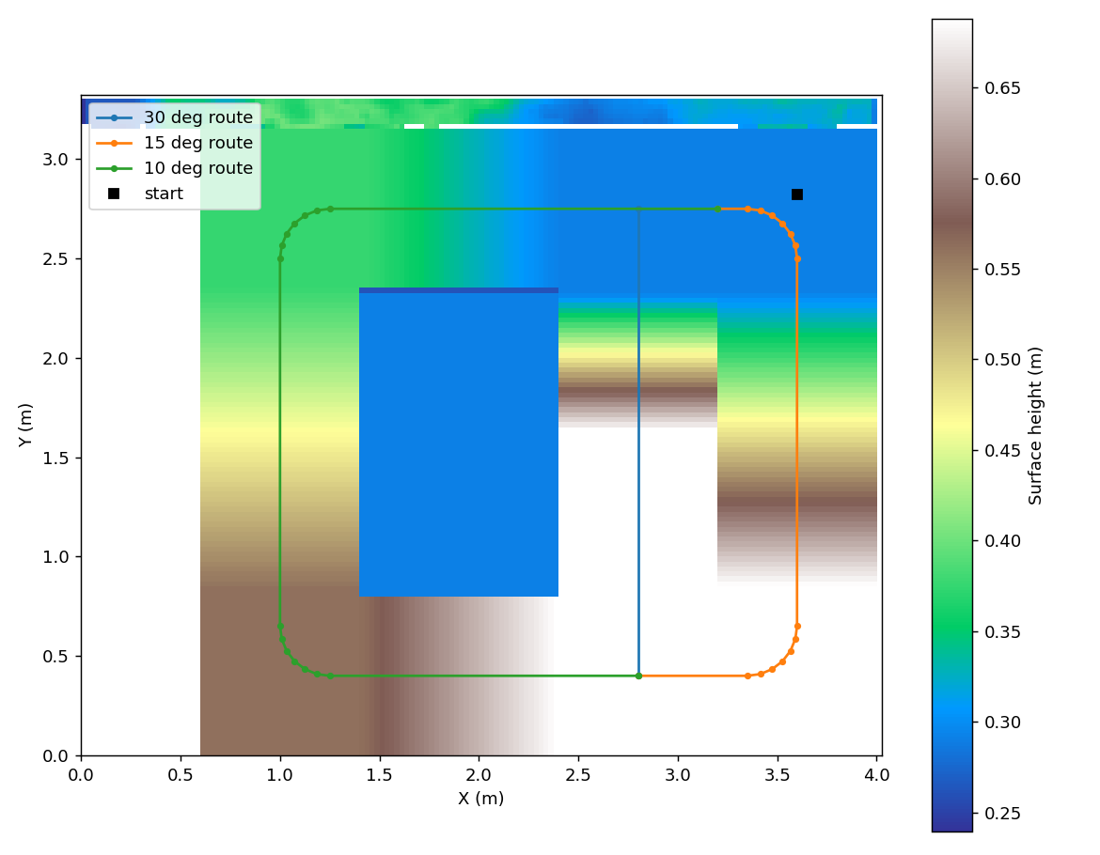
ksrc_final_20261022/mission/preview.png
