cmwcmw57/pi-backup/ksrc/ros/rover_description/meshes/base_link_sim.stl

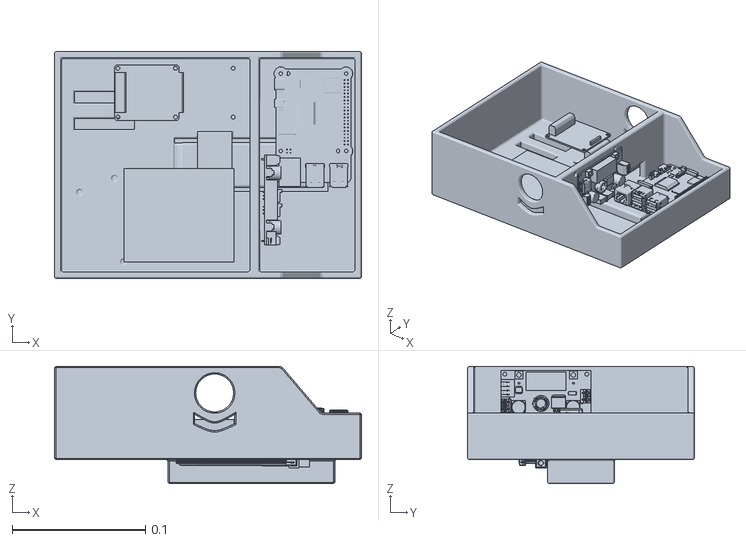
[picture p7: CAD file, 2026-10-23]
ksrc/ros/rover_description/meshes/base_link_sim.stl
0.23 x 0.17 x 0.088
