cmwcmw57/pi-backup/ksrc/ros/rover_description/meshes/inertial_parts/component_6038.stl

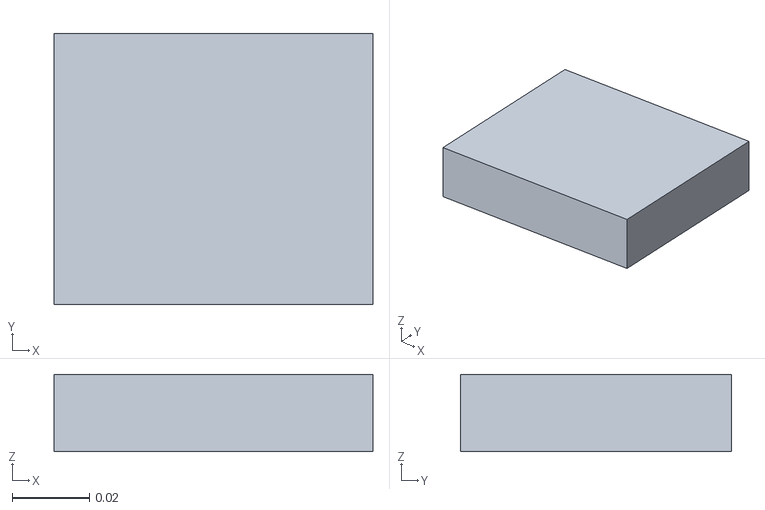
[picture p8: CAD file, 2026-10-23]
ksrc/ros/rover_description/meshes/inertial_parts/component_6038.stl
0.0825 x 0.07 x 0.02
