cmwcmw57/pi-backup/ksrc_final_20261022/experiments/localization/assets/gyusa_fence40.stl

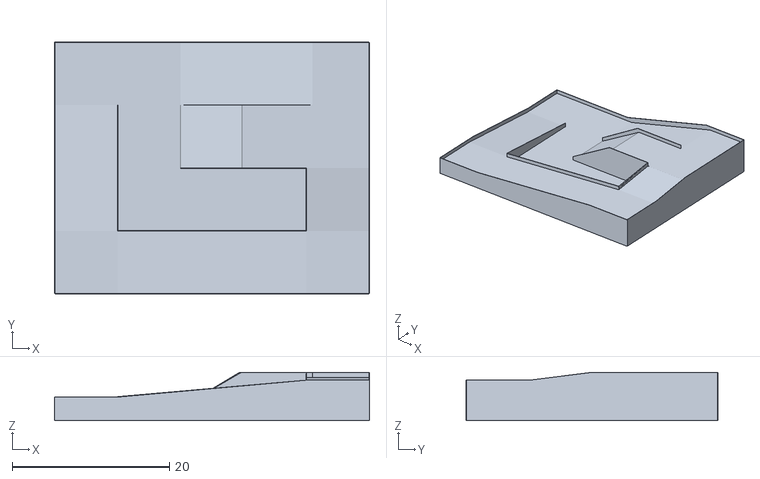
[picture p9: CAD file, 2026-10-23]
ksrc_final_20261022/experiments/localization/assets/gyusa_fence40.stl
40.1 x 32.1 x 6.15
