cmwcmw57/pi-backup/ksrc/ros/rover_description/meshes/inertial_parts/component_5132.stl

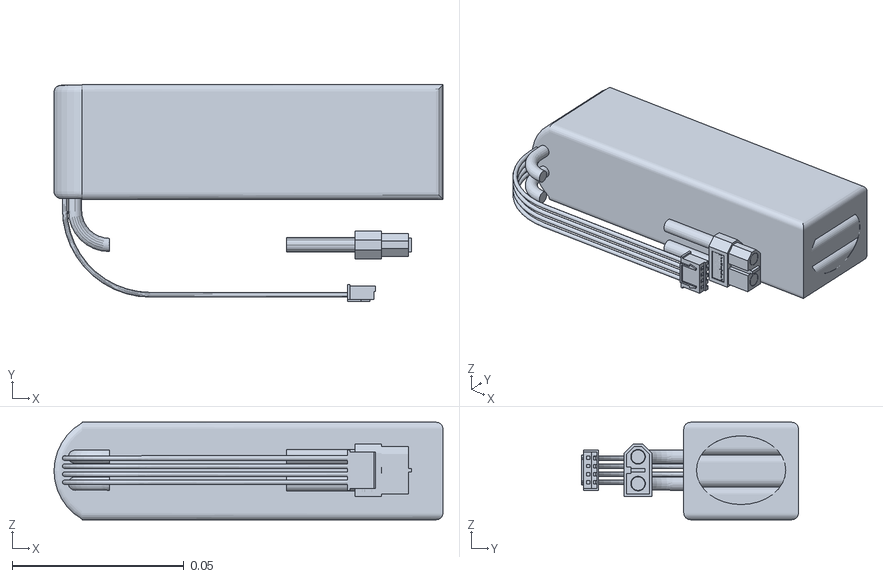
[picture p10: CAD file, 2026-10-23]
ksrc/ros/rover_description/meshes/inertial_parts/component_5132.stl
0.113 x 0.0631 x 0.0284
