cmwcmw57/pi-backup/ksrc/ros/rover_description/meshes/right_rocker_link.stl

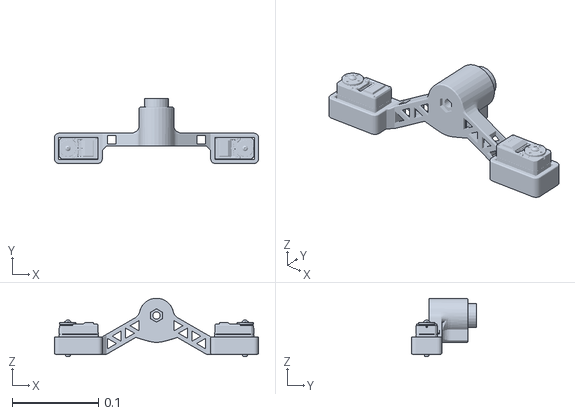
[picture p11: CAD file, 2026-10-23]
ksrc/ros/rover_description/meshes/right_rocker_link.stl
0.236 x 0.075 x 0.0675
