cmwcmw57/pi-backup/ksrc/ros/rover_description/meshes/inertial_parts/component_338.stl

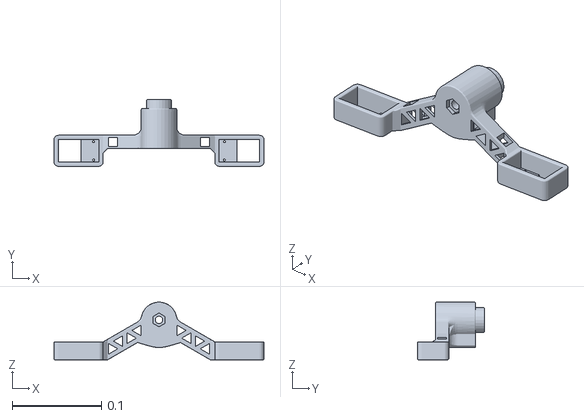
[picture p12: CAD file, 2026-10-23]
ksrc/ros/rover_description/meshes/inertial_parts/component_338.stl
0.236 x 0.075 x 0.0647
