cmwcmw57/pi-backup/ksrc/ros/rover_description/meshes/inertial_parts/component_5293.stl

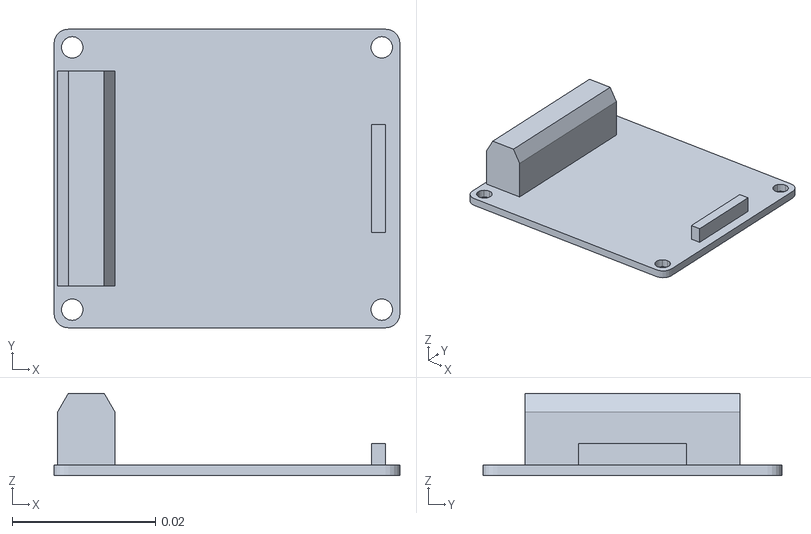
[picture p13: CAD file, 2026-10-23]
ksrc/ros/rover_description/meshes/inertial_parts/component_5293.stl
0.0483 x 0.0417 x 0.0115
