cmwcmw57/pi-backup/ksrc/ros/rover_description/meshes/rr_steering_link.stl

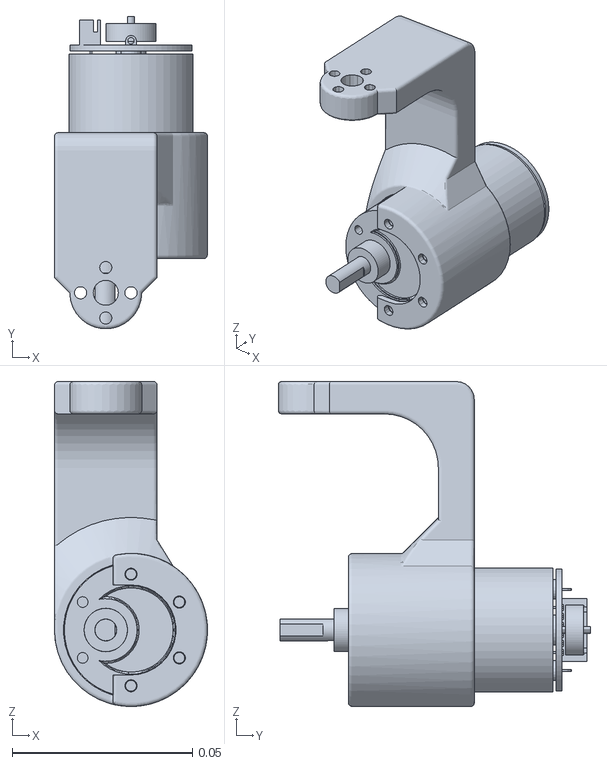
[picture p14: CAD file, 2026-10-23]
ksrc/ros/rover_description/meshes/rr_steering_link.stl
0.0425 x 0.0867 x 0.0902
