cmwcmw57/pi-backup/ksrc/ros/rover_description/meshes/inertial_parts/component_3608.stl

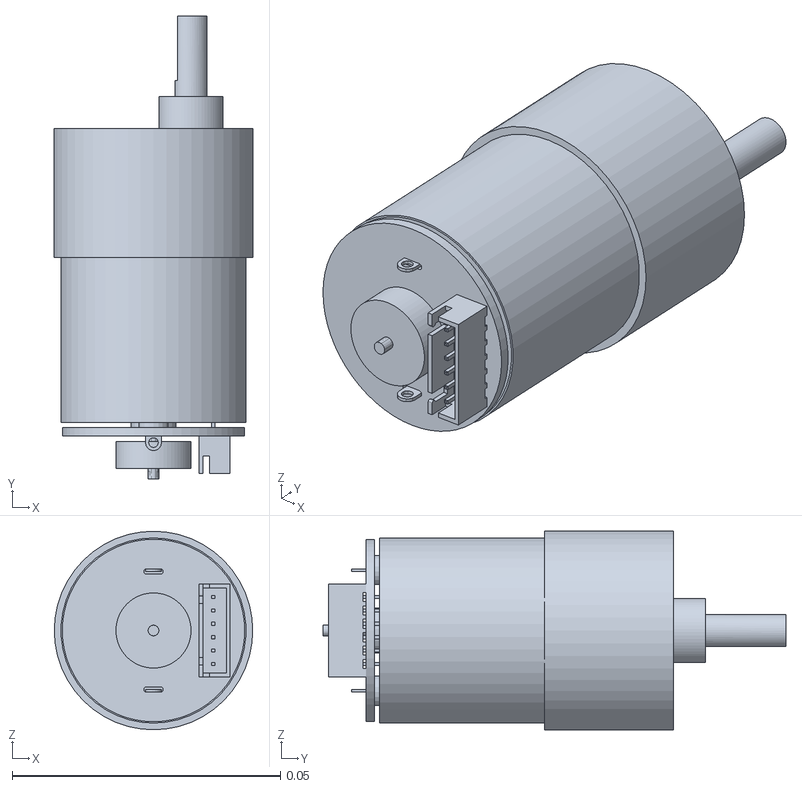
[picture p15: CAD file, 2026-10-23]
ksrc/ros/rover_description/meshes/inertial_parts/component_3608.stl
0.037 x 0.0863 x 0.037
