cmwcmw57/pi-backup/ksrc/ros/rover_description/meshes/inertial_parts/component_4165.stl

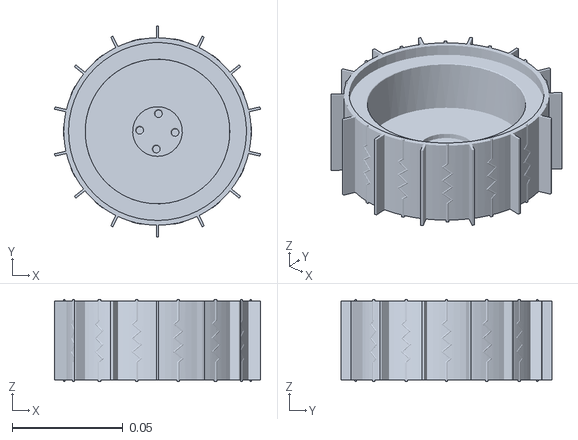
[picture p16: CAD file, 2026-10-23]
ksrc/ros/rover_description/meshes/inertial_parts/component_4165.stl
0.0929 x 0.095 x 0.0372
