cmwcmw57/pi-backup/ksrc/ros/rover_description/meshes/imu_link.stl

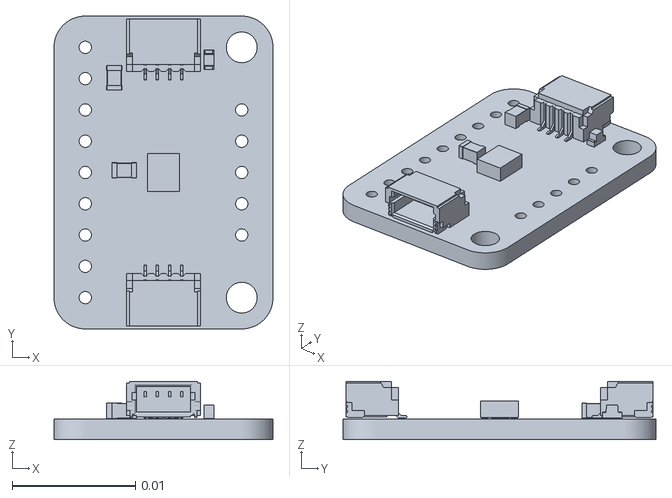
[picture p17: CAD file, 2026-10-23]
ksrc/ros/rover_description/meshes/imu_link.stl
0.0178 x 0.0254 x 0.00473
