cmwcmw57/pi-backup/ksrc/ros/rover_description/meshes/inertial_parts/component_674.stl

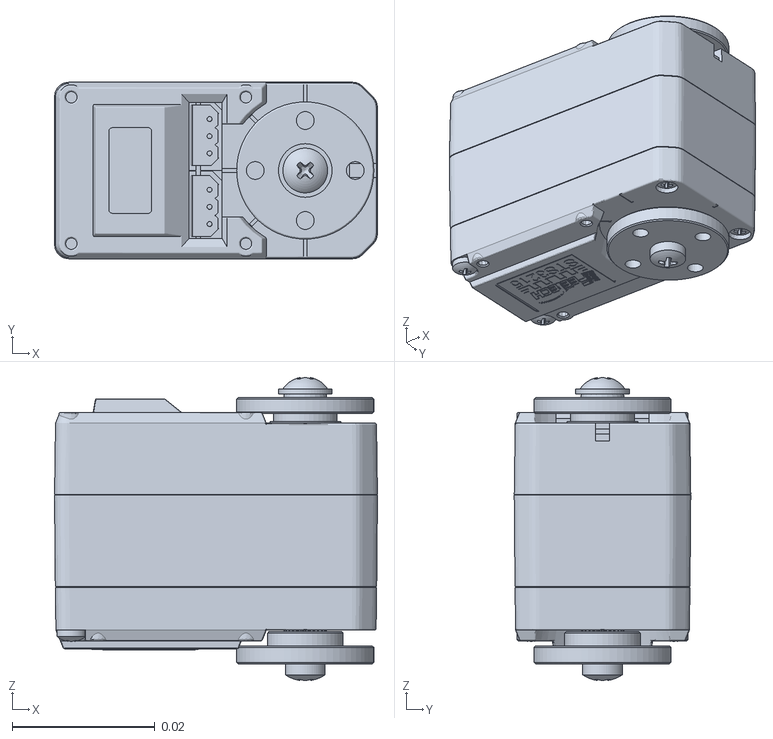
[picture p18: CAD file, 2026-10-23]
ksrc/ros/rover_description/meshes/inertial_parts/component_674.stl
0.0452 x 0.0247 x 0.0424
