cmwcmw57/pi-backup/ksrc/ros/rover_description/meshes/inertial_parts/component_5661.stl

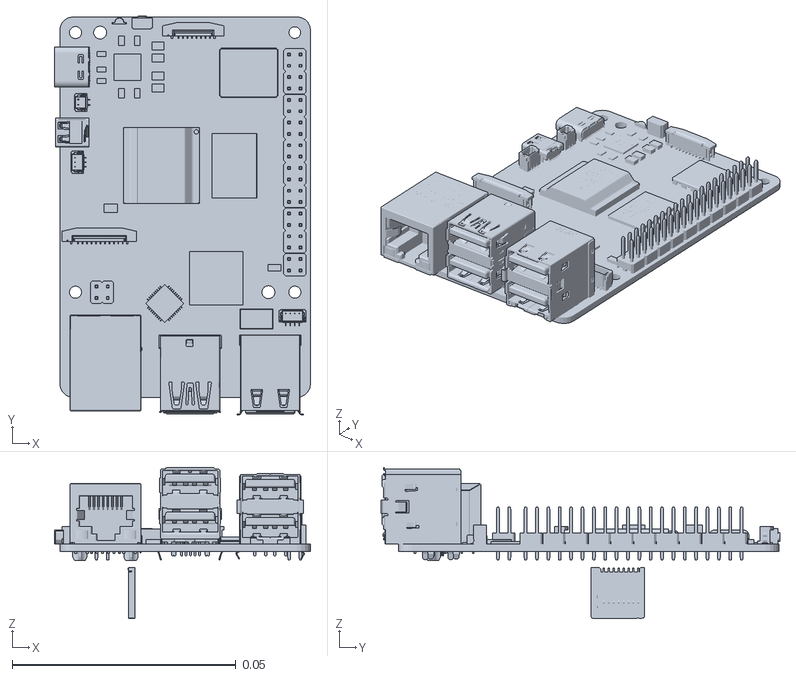
[picture p19: CAD file, 2026-10-23]
ksrc/ros/rover_description/meshes/inertial_parts/component_5661.stl
0.0572 x 0.089 x 0.0338
