cmwcmw57/pi-backup/ksrc/ros/rover_description/meshes/camera_link.stl

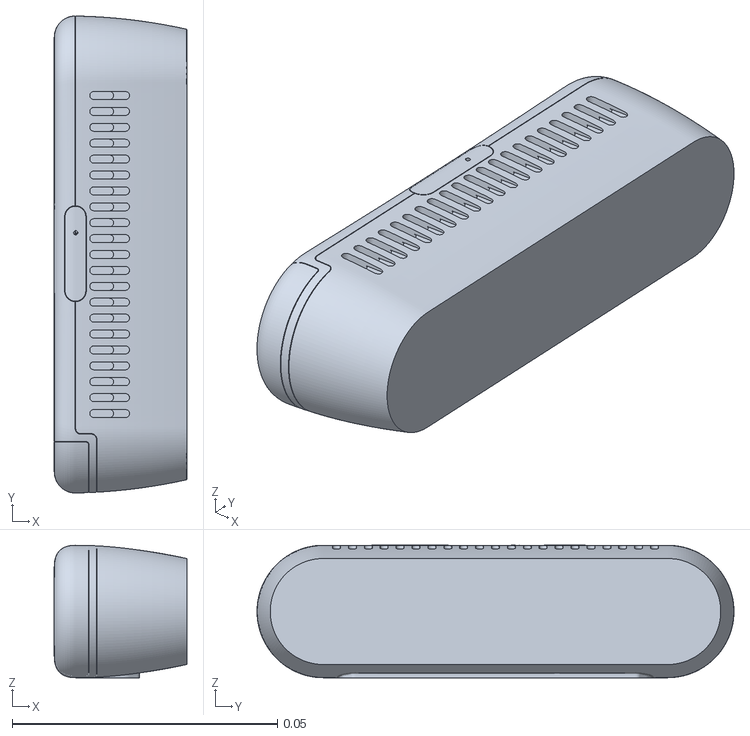
[picture p20: CAD file, 2026-10-23]
ksrc/ros/rover_description/meshes/camera_link.stl
0.025 x 0.09 x 0.025
