cmwcmw57/pi-backup/ksrc/ros/rover_description/meshes/inertial_parts/component_2063.stl

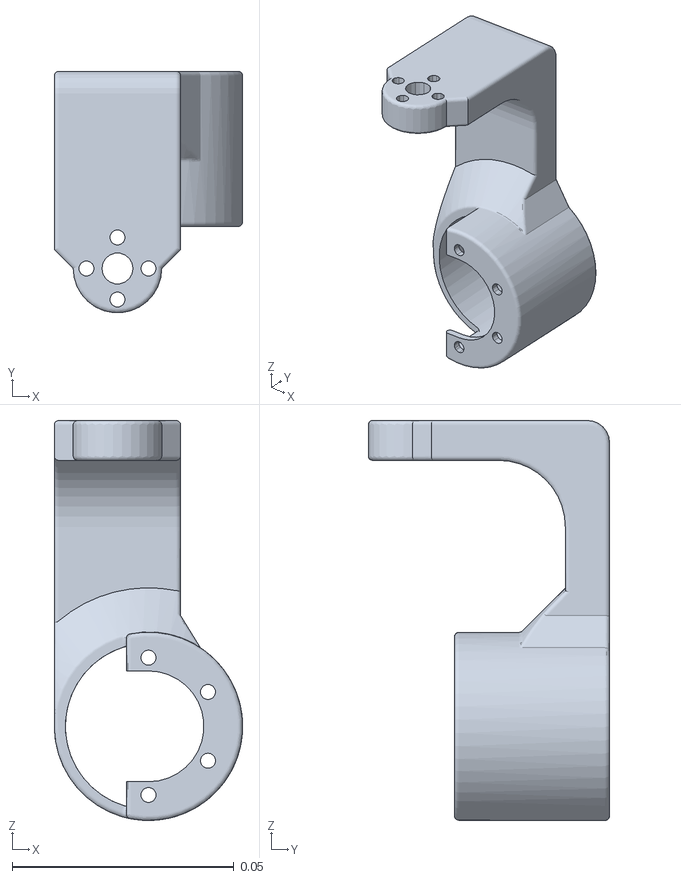
[picture p21: CAD file, 2026-10-23]
ksrc/ros/rover_description/meshes/inertial_parts/component_2063.stl
0.0425 x 0.0544 x 0.0902
