cmwcmw57/pi-backup/ksrc/ros/rover_description/meshes/inertial_parts/component_203.stl

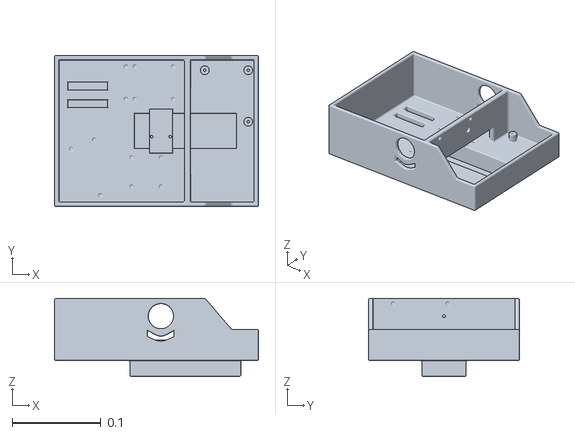
[picture p22: CAD file, 2026-10-23]
ksrc/ros/rover_description/meshes/inertial_parts/component_203.stl
0.23 x 0.17 x 0.088
