cmwcmw57/pi-backup/ksrc/ros/rover_description/meshes/inertial_parts/component_5010.stl

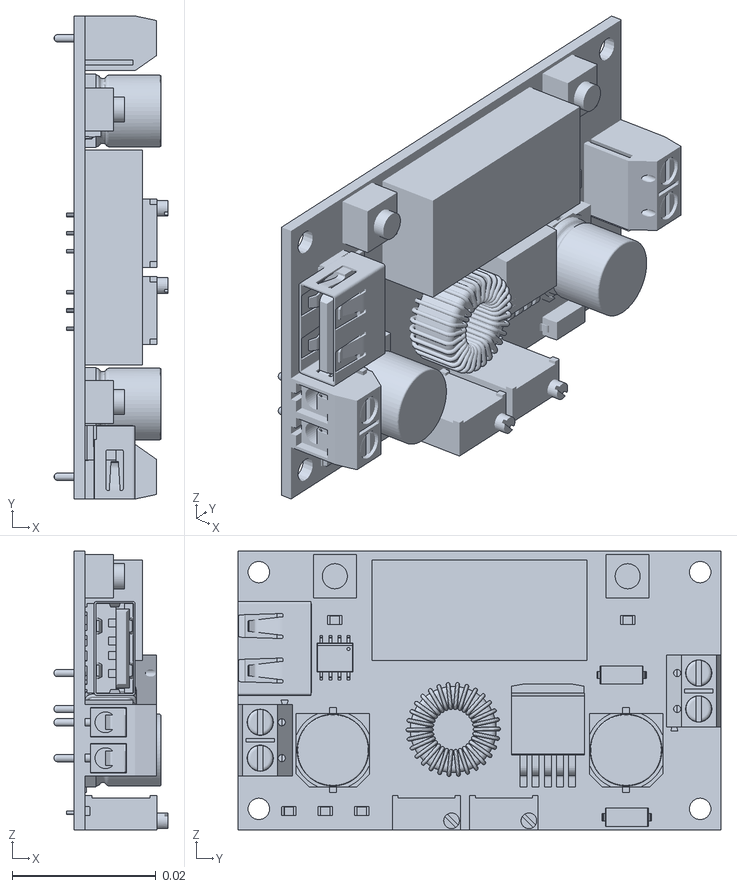
[picture p23: CAD file, 2026-10-23]
ksrc/ros/rover_description/meshes/inertial_parts/component_5010.stl
0.0159 x 0.0673 x 0.0389
