cmwcmw57/pi-backup/ksrc/ros/rover_description/meshes/inertial_parts/component_sensor_d435.stl

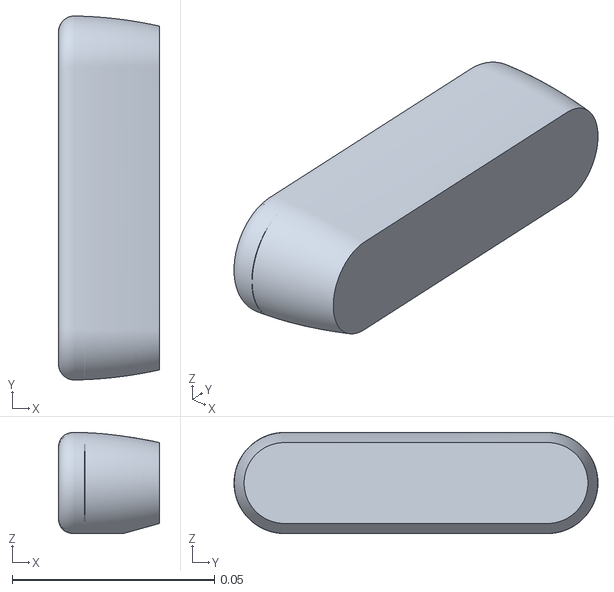
[picture p24: CAD file, 2026-10-23]
ksrc/ros/rover_description/meshes/inertial_parts/component_sensor_d435.stl
0.025 x 0.09 x 0.025
