cmwcmw57/pi-backup/(list of files, cad)

Other CAD files:
ksrc/orb/vo1018_02/map_0.ply
ksrc/orb/vo1018_03/map_62.ply
ksrc/orb/vo1018_04/map_0.ply
ksrc/orb/vo1018_10/map_304.ply
ksrc/orb/vo1018_11/map_185.ply
ksrc/orb/vo1018_13/map_946.ply
ksrc/orb/vo1018_16/map_313.ply
ksrc_final_20261022/deployment/ksrc/state/field_S1_20261022_215621/orb_001/map_0.ply
ksrc_final_20261022/deployment/ksrc/state/field_S1_20261022_221150/orb_001/map_0.ply
ksrc_final_20261022/deployment/ksrc/state/field_S1_20261022_222716/orb_001/map_0.ply
ksrc_final_20261022/deployment/ksrc/state/field_S1_20261022_223146/orb_001/map_0.ply
ksrc_final_20261022/deployment/ksrc/state/field_S1_20261022_223754/orb_001/map_0.ply
ksrc_final_20261022/deployment/ksrc/state/field_S1_20261022_223923/orb_001/map_0.ply
ksrc_final_20261022/deployment/ksrc/state/field_S1_20261022_224311/orb_001/map_0.ply
ksrc_final_20261022/deployment/ksrc/state/field_S1_20261022_230327/orb_001/map_0.ply
ksrc_final_20261022/deployment/ksrc/state/field_S1_20261022_232035/orb_001/map_0.ply
ksrc_final_20261022/deployment/ksrc/state/field_S1_20261022_232130/orb_001/map_0.ply
ksrc_final_20261022/deployment/ksrc/state/field_S1_20261022_232224/orb_001/map_0.ply
ksrc_final_20261022/deployment/ksrc/state/field_S1_20261022_232347/orb_001/map_0.ply
ksrc_final_20261022/deployment/ksrc/state/field_S1_20261023_150222/orb_001/map_0.ply
ksrc_final_20261022/deployment/ksrc/state/field_S1_20261023_150234/orb_001/map_15.ply
ksrc_final_20261022/deployment/ksrc/state/real_idle_20261022_215101/orb_001/map_0.ply
ksrc_final_20261022/mission/site/mesh.ply
ksrc/ros/rover_description/meshes/base_link.stl
ksrc/ros/rover_description/meshes/left_rocker_link.stl
ksrc/ros/rover_description/meshes/rl_wheel_link.stl
ksrc/ros/rover_description/meshes/rr_wheel_link.stl
ksrc/ros/rover_description/meshes/fr_steering_link.stl
ksrc/ros/rover_description/meshes/inertial_parts/component_5516.stl
ksrc/ros/rover_description/meshes/fl_wheel_link.stl
ksrc/ros/rover_description/meshes/inertial_parts/component_211.stl
ksrc/ros/rover_description/meshes/fr_wheel_link.stl
ksrc/ros/rover_description/meshes/inertial_parts/component_1783.stl
ksrc/ros/rover_description/meshes/inertial_parts/component_1501.stl
ksrc/ros/rover_description/meshes/rl_steering_link.stl
ksrc/ros/rover_description/meshes/fl_steering_link.stl
ksrc/ros/rover_description/meshes/inertial_parts/component_2946.stl
ksrc/ros/rover_description/meshes/inertial_parts/component_3080.stl
ksrc/ros/rover_description/meshes/inertial_parts/component_2394.stl
ksrc/ros/rover_description/meshes/inertial_parts/component_sensor_imu.stl
ksrc/ros/rover_description/meshes/inertial_parts/component_3596.stl
ksrc/ros/rover_description/meshes/inertial_parts/component_4309.stl
ksrc/ros/rover_description/meshes/inertial_parts/component_6734.stl
ksrc/ros/rover_description/meshes/inertial_parts/component_2812.stl
ksrc/ros/rover_description/meshes/inertial_parts/component_465.stl
ksrc/ros/rover_description/meshes/inertial_parts/component_3247.stl
