cmwcmw57/pi-backup/ksrc/ros/rover_description/docs/assembly_preview.png

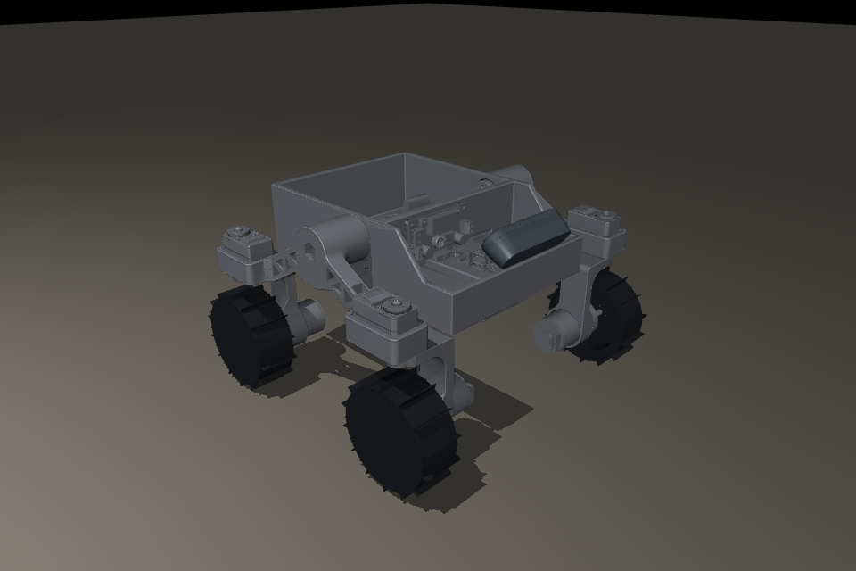
ksrc/ros/rover_description/docs/assembly_preview.png
