cmwcmw57/pi-backup/ksrc_final_20261022/deployment/ksrc/local/orb.yaml

%YAML:1.0
---
File.version: "1.0"
Camera.type: "PinHole"
Camera.RGB: 0
Stereo.ThDepth: 60.0
IMU.NoiseGyro: 0.00017
IMU.NoiseAcc: 0.002
IMU.GyroWalk: 1.9393e-05
IMU.AccWalk: 0.003
ORBextractor.nFeatures: 1200
ORBextractor.scaleFactor: 1.2
ORBextractor.nLevels: 8
ORBextractor.iniThFAST: 20
ORBextractor.minThFAST: 7
Viewer.KeyFrameSize: 0.05
Viewer.KeyFrameLineWidth: 1.0
Viewer.GraphLineWidth: 0.9
Viewer.PointSize: 2.0
Viewer.CameraSize: 0.08
Viewer.CameraLineWidth: 3.0
Viewer.ViewpointX: 0.0
Viewer.ViewpointY: -0.7
Viewer.ViewpointZ: -1.8
Viewer.ViewpointF: 500.0
Viewer.imageViewScale: 1.0
Camera1.fx: 377.1861267089844
Camera1.fy: 377.1861267089844
Camera1.cx: 320.54248046875
Camera1.cy: 241.73216247558594
Camera1.k1: 0.0
Camera1.k2: 0.0
Camera1.p1: 0.0
Camera1.p2: 0.0
Camera2.fx: 377.1861267089844
Camera2.fy: 377.1861267089844
Camera2.cx: 320.54248046875
Camera2.cy: 241.73216247558594
Camera2.k1: 0.0
Camera2.k2: 0.0
Camera2.p1: 0.0
Camera2.p2: 0.0
Camera.width: 640
Camera.height: 480
Camera.fps: 15
IMU.Frequency: 200.0
Stereo.T_c1_c2: !!opencv-matrix
  rows: 4
  cols: 4
  dt: f
  data: [ 1, 0, 0, 0.0499182604, 0, 1, 0, 0, 0, 0, 1, 0, 0, 0, 0, 1 ]
IMU.T_b_c1: !!opencv-matrix
  rows: 4
  cols: 4
  dt: f
  data: [ -9.71750688e-14, -0.342020273, 0.939692557, 0.142992392, -1, 1.06939494e-26, -1.03411556e-13, 0.0249745157, 3.536885e-14, -0.939692557, -0.342020273, 0.0366908759, 0, 0, 0, 1 ]
ROS.T_c1_base: !!opencv-matrix
  rows: 4
  cols: 4
  dt: f
  data: [ -9.71750688e-14, -1, 3.536885e-14, 0.0249745157, -0.342020273, 1.06939494e-26, -0.939692557, 0.0570477843, 0.939692557, -1.03411556e-13, -0.342020273, -0.112243354, 0, 0, 0, 1 ]
ROS.pose_output: "base"
