cmwcmw57/pi-backup/ksrc/firmware/src2026-rover-firmware/gen_makefile.py

#!/usr/bin/env python3
"""Generate Makefile with proper TAB characters for GNU Make."""

lines = [
    "######################################",
    "# target",
    "######################################",
    "TARGET = rover_motor",
    "",
    "######################################",
    "# building variables",
    "######################################",
    "DEBUG = 1",
    "OPT = -Og",
    "",
    "#######################################",
    "# paths",
    "#######################################",
    "BUILD_DIR = build",
    "",
    "######################################",
    "# source",
    "######################################",
    "C_SOURCES = \\",
    "Core/Src/main.c \\",
    "Core/Src/motor.c \\",
    "Core/Src/encoder.c \\",
    "Core/Src/stm32f4xx_it.c \\",
    "Core/Src/stm32f4xx_hal_msp.c \\",
    "Core/Src/system_stm32f4xx.c \\",
    "Drivers/STM32F4xx_HAL_Driver/Src/stm32f4xx_hal.c \\",
    "Drivers/STM32F4xx_HAL_Driver/Src/stm32f4xx_hal_cortex.c \\",
    "Drivers/STM32F4xx_HAL_Driver/Src/stm32f4xx_hal_dma.c \\",
    "Drivers/STM32F4xx_HAL_Driver/Src/stm32f4xx_hal_dma_ex.c \\",
    "Drivers/STM32F4xx_HAL_Driver/Src/stm32f4xx_hal_exti.c \\",
    "Drivers/STM32F4xx_HAL_Driver/Src/stm32f4xx_hal_flash.c \\",
    "Drivers/STM32F4xx_HAL_Driver/Src/stm32f4xx_hal_flash_ex.c \\",
    "Drivers/STM32F4xx_HAL_Driver/Src/stm32f4xx_hal_flash_ramfunc.c \\",
    "Drivers/STM32F4xx_HAL_Driver/Src/stm32f4xx_hal_gpio.c \\",
    "Drivers/STM32F4xx_HAL_Driver/Src/stm32f4xx_hal_pwr.c \\",
    "Drivers/STM32F4xx_HAL_Driver/Src/stm32f4xx_hal_pwr_ex.c \\",
    "Drivers/STM32F4xx_HAL_Driver/Src/stm32f4xx_hal_rcc.c \\",
    "Drivers/STM32F4xx_HAL_Driver/Src/stm32f4xx_hal_rcc_ex.c \\",
    "Drivers/STM32F4xx_HAL_Driver/Src/stm32f4xx_hal_tim.c \\",
    "Drivers/STM32F4xx_HAL_Driver/Src/stm32f4xx_hal_tim_ex.c",
    "",
    "ASM_SOURCES = \\",
    "Core/Startup/startup_stm32f446retx.s",
    "",
    "#######################################",
    "# binaries",
    "#######################################",
    "PREFIX = arm-none-eabi-",
    "CC = $(PREFIX)gcc",
    "AS = $(PREFIX)gcc -x assembler-with-cpp",
    "CP = $(PREFIX)objcopy",
    "SZ = $(PREFIX)size",
    "HEX = $(CP) -O ihex",
    "BIN = $(CP) -O binary -S",
    "",
    "#######################################",
    "# CFLAGS",
    "#######################################",
    "CPU = -mcpu=cortex-m4",
    "FPU = -mfpu=fpv4-sp-d16",
    "FLOAT-ABI = -mfloat-abi=hard",
    "MCU = $(CPU) -mthumb $(FPU) $(FLOAT-ABI)",
    "",
    "AS_DEFS =",
    "C_DEFS = -DUSE_HAL_DRIVER -DSTM32F446xx",
    "",
    "AS_INCLUDES =",
    "C_INCLUDES = \\",
    "-ICore/Inc \\",
    "-IDrivers/STM32F4xx_HAL_Driver/Inc \\",
    "-IDrivers/STM32F4xx_HAL_Driver/Inc/Legacy \\",
    "-IDrivers/CMSIS/Device/ST/STM32F4xx/Include \\",
    "-IDrivers/CMSIS/Include",
    "",
    "ASFLAGS = $(MCU) $(AS_DEFS) $(AS_INCLUDES) $(OPT) -Wall -fdata-sections -ffunction-sections",
    "CFLAGS += $(MCU) $(C_DEFS) $(C_INCLUDES) $(OPT) -Wall -fdata-sections -ffunction-sections",
    "",
    "ifeq ($(DEBUG), 1)",
    "CFLAGS += -g -gdwarf-2",
    "endif",
    "",
    'CFLAGS += -MMD -MP -MF"$(@:%.o=%.d)"',
    "",
    "#######################################",
    "# LDFLAGS",
    "#######################################",
    "LDSCRIPT = STM32F446RETX_FLASH.ld",
    "LIBS = -lc -lm -lnosys",
    "LIBDIR =",
    "LDFLAGS = $(MCU) -specs=nano.specs -T$(LDSCRIPT) $(LIBDIR) $(LIBS) -Wl,-Map=$(BUILD_DIR)/$(TARGET).map,--cref -Wl,--gc-sections",
    "",
    "#######################################",
    "# build the application",
    "#######################################",
    "OBJECTS = $(addprefix $(BUILD_DIR)/,$(notdir $(C_SOURCES:.c=.o)))",
    "vpath %.c $(sort $(dir $(C_SOURCES)))",
    "",
    "OBJECTS += $(addprefix $(BUILD_DIR)/,$(notdir $(ASM_SOURCES:.s=.o)))",
    "vpath %.s $(sort $(dir $(ASM_SOURCES)))",
    "",
    "all: $(BUILD_DIR)/$(TARGET).elf $(BUILD_DIR)/$(TARGET).hex $(BUILD_DIR)/$(TARGET).bin",
    "",
    "$(BUILD_DIR)/%.o: %.c Makefile | $(BUILD_DIR)",
    "\t$(CC) -c $(CFLAGS) -Wa,-a,-ad,-alms=$(BUILD_DIR)/$(notdir $(<:.c=.lst)) $< -o $@",
    "",
    "$(BUILD_DIR)/%.o: %.s Makefile | $(BUILD_DIR)",
    "\t$(AS) -c $(ASFLAGS) $< -o $@",
    "",
    "$(BUILD_DIR)/$(TARGET).elf: $(OBJECTS) Makefile",
    "\t$(CC) $(OBJECTS) $(LDFLAGS) -o $@",
    "\t$(SZ) $@",
    "",
    "$(BUILD_DIR)/%.hex: $(BUILD_DIR)/%.elf | $(BUILD_DIR)",
    "\t$(HEX) $< $@",
    "",
    "$(BUILD_DIR)/%.bin: $(BUILD_DIR)/%.elf | $(BUILD_DIR)",
    "\t$(BIN) $< $@",
    "",
    "$(BUILD_DIR):",
    "\tmkdir $@",
    "",
    "#######################################",
    "# clean up",
    "#######################################",
    "clean:",
    "\t-rm -fR $(BUILD_DIR)",
    "",
    "-include $(wildcard $(BUILD_DIR)/*.d)",
    "",
    ".PHONY: all clean",
]

import os
makefile_path = os.path.join(r"D:\STM32_Projects\rover_motor", "Makefile")
with open(makefile_path, "w", newline="\n") as f:
    f.write("\n".join(lines) + "\n")

# Verify
with open(makefile_path, "r") as f:
    content = f.read()
tab_count = content.count("\t")
has_all = "all:" in content
print(f"Makefile written: {len(content)} bytes, {tab_count} tabs, all target: {has_all}")
