cmwcmw57/pi-backup/ksrc/firmware/common/tests/test_drive_align_gate.c

/*
 * 구동 정렬 게이트 호스트 테스트. STM32/HAL 불필요:
 *   gcc -std=c99 -Wall -Wextra -I.. -o /tmp/gate_test test_drive_align_gate.c ../drive_align_gate.c -lm && /tmp/gate_test
 */
#include "drive_align_gate.h"
#include <math.h>
#include <stdio.h>

#define DEG (3.14159265358979323846f / 180.0f)

static int g_fail = 0;

static void expect_int(const char *label, int got, int want)
{
    if (got != want) {
        printf("FAIL %s: got %d want %d\n", label, got, want);
        g_fail = 1;
    } else {
        printf("ok   %s: %d\n", label, got);
    }
}

int main(void)
{
    drive_align_gate_t g;
    const float zero[4] = {0, 0, 0, 0};
    const float fwd[4]  = {0.1f, 0.1f, 0.1f, 0.1f};

    /* 1) 첫 구동 명령은 대기로 시작, 실제각이 맞으면 즉시 해제 */
    drive_gate_init(&g, 60.0f * DEG, 10.0f * DEG, 0);
    expect_int("first.pending", drive_gate_update_goal(&g, zero, fwd), 1);
    expect_int("first.allow_aligned", drive_gate_allow(&g, zero, zero, 1), 1);

    /* 2) 작은 변화(30도)는 대기를 만들지 않는다 */
    {
        const float g30[4] = {30 * DEG, 30 * DEG, 30 * DEG, 30 * DEG};
        expect_int("small.pending", drive_gate_update_goal(&g, g30, fwd), 0);
        expect_int("small.allow", drive_gate_allow(&g, g30, zero, 1), 1);
    }

    /* 3) 한 바퀴만 90도 바뀌어도 대기, 10도 밖이면 보류, 안에 들면 해제 */
    {
        const float goal[4] = {120 * DEG, 30 * DEG, 30 * DEG, 30 * DEG};
        const float far[4]  = { 60 * DEG, 30 * DEG, 30 * DEG, 30 * DEG};
        const float near[4] = {112 * DEG, 31 * DEG, 29 * DEG, 30 * DEG};
        expect_int("big.pending", drive_gate_update_goal(&g, goal, fwd), 1);
        expect_int("big.hold_far", drive_gate_allow(&g, goal, far, 1), 0);
        /* 목표가 그대로면 update 를 다시 불러도 대기 유지 */
        expect_int("big.still_pending", drive_gate_update_goal(&g, goal, fwd), 1);
        expect_int("big.hold_read_fail", drive_gate_allow(&g, goal, near, 0), 0);
        expect_int("big.release_near", drive_gate_allow(&g, goal, near, 1), 1);
    }

    /* 4) 정지 명령(속도 0)으로 큰 조향 변화는 대기를 만들지 않는다 */
    {
        const float goal[4] = {-60 * DEG, -60 * DEG, 30 * DEG, 30 * DEG};
        expect_int("stopped.no_pending", drive_gate_update_goal(&g, goal, zero), 0);
    }
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
