cmwcmw57/pi-backup/(notices)

Notices in the files:
ksrc/firmware/src2026-rover-firmware/Core/Src/main.c:
Copyright (c) 2026 STMicroelectronics.
All rights reserved.
This software is licensed under terms that can be found in the LICENSE file
